X-Microsystems/xmicro-cf/README.md

# XMICRO-CF

[XMICRO](https://github.com/x-microsystems/xmicro-bus) card providing a CompactFlash card interface and real-time
clock.

Datasheet: [XMICRO-CF](Documentation/XMICRO-CF.pdf)

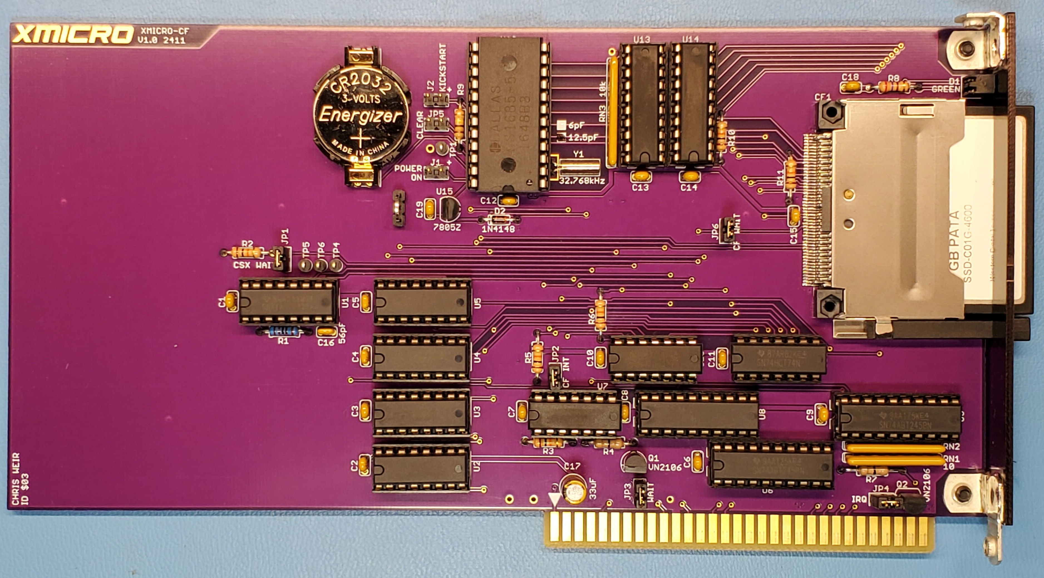
[picture p1: Images/XMICRO-CF 1.jpg]
XMICRO-CF
