X-Microsystems/xmicro-cf/Documentation/Schematics/Netlist.txt

Netlist

Exported from XMICRO-CF V1.0.sch at 2024-04-06 16:05:32

EAGLE Version 6.3.0 Copyright (c) 1988-2012 CadSoft

Net      Part     Pad      Pin        Sheet

!BCSX    P1       9        !CSX       1
         U8       2        A          1

!BIRQX   JP4      2        2          5
         P1       52       !IRQX      1

!BRD     P1       19       !RD        1
         U10      4        I0         1
         U8       3        A          1

!BRST    P1       10       !RST       1
         U7       5        I          1

!BWAIT   JP3      2        2          5
         P1       16       !WAIT      1

!BWR     P1       20       !WR        1
         U10      5        I1         1
         U8       4        A          1

!CF_CD   CF1      26       !CD1       2
         R10      2        2          2
         U14      4        A3         4

!CSX     TP4      1        1          5
         U1       9        A          5
         U2       4        G2A        4
         U3       4        G2A        4
         U4       4        G2A        4
         U8       18       B          1
         U9       19       !OE        1

!CS_CF0  CF1      7        !CS0       2
         U2       15       Y0         4

!CS_CF1  CF1      32       !CS1       2
         U2       14       Y1         4

!CS_ID   U13      19       !OE        4
         U4       7        Y7         4

!CS_IER  U11      11       CLK        5
         U3       15       Y0         4

!CS_RTC  U12      13       !CS        3
         U2       13       Y2         4
         U5       4        G2A        3

!CS_SR   U14      19       !OE        4
         U4       15       Y0         4

!INT_RTC R3       2        2          3
         U10      13       I1         5
         U12      19       !IRQ       3
         U7       3        I          5

!RD      CF1      34       !IORD      2
         U4       5        G2B        4
         U5       3        C          3
         U8       17       B          1
         U9       1        DIR        1

!RST     CF1      41       /RESET     2
         U1       11       CLR        5
         U11      10       PRE        5
         U7       8        O          1

!WAIT_CF CF1      42       IORDY      2
         JP6      1        1          5

!WAIT_CSX JP1      1        1          5
         TP5      1        1          5
         U1       12       !Q         5

!WR      CF1      35       !IOWR      2
         U3       5        G2B        4
         U5       2        B          3
         U8       16       B          1

+5V      C1       1        1          5
         C10      1        1          5
         C11      1        1          5
         C13      1        1          5
         C14      1        1          5
         C15      1        1          5
         C17      +        +          5
         C18      1        1          5
         C2       1        1          5
         C3       1        1          5
         C4       1        1          5
         C5       1        1          5
         C6       1        1          5
         C7       1        1          5
         C8       1        1          5
         C9       1        1          5
         CF1      13       +5V        * none *
         CF1      36       !WE        2
         CF1      38       +5V        * none *
         CF1      44       !DMACK     2
         P1       5        +5V        1
         P1       6        +5V        1
         R1       2        2          5
         R10      1        1          2
         R11      2        2          2
         R2       2        2          5
         R3       1        1          3
         R5       2        2          5
         R6       2        2          5
         R8       2        2          2
         RN3      1        1          1
         U1       1        A          5
         U1       16       +5V        * none *
         U1       2        B          5
         U1       3        CLR        5
         U10      14       +5V        * none *
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

N$47     R7       1        1          5
         U7       12       O          5

RWCYCLE  TP6      1        1          1
         U1       10       B          5
         U10      6        O          1

SR_RTC   U14      2        A1         4
         U7       4        O          5
