X-Microsystems/xmicro-cf/Documentation/XMICRO-CF.odt

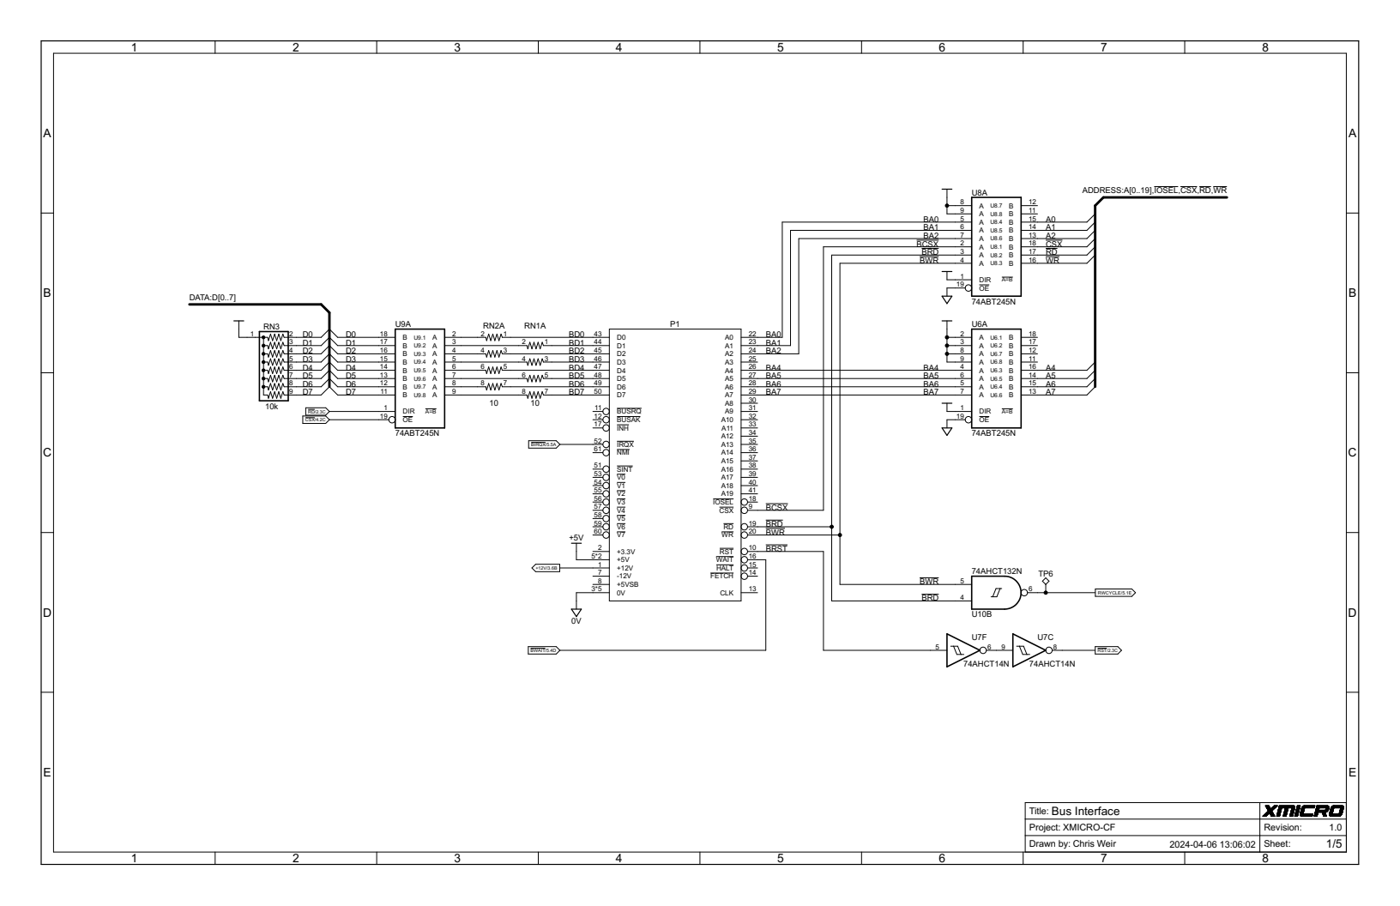
[picture p2: figure]
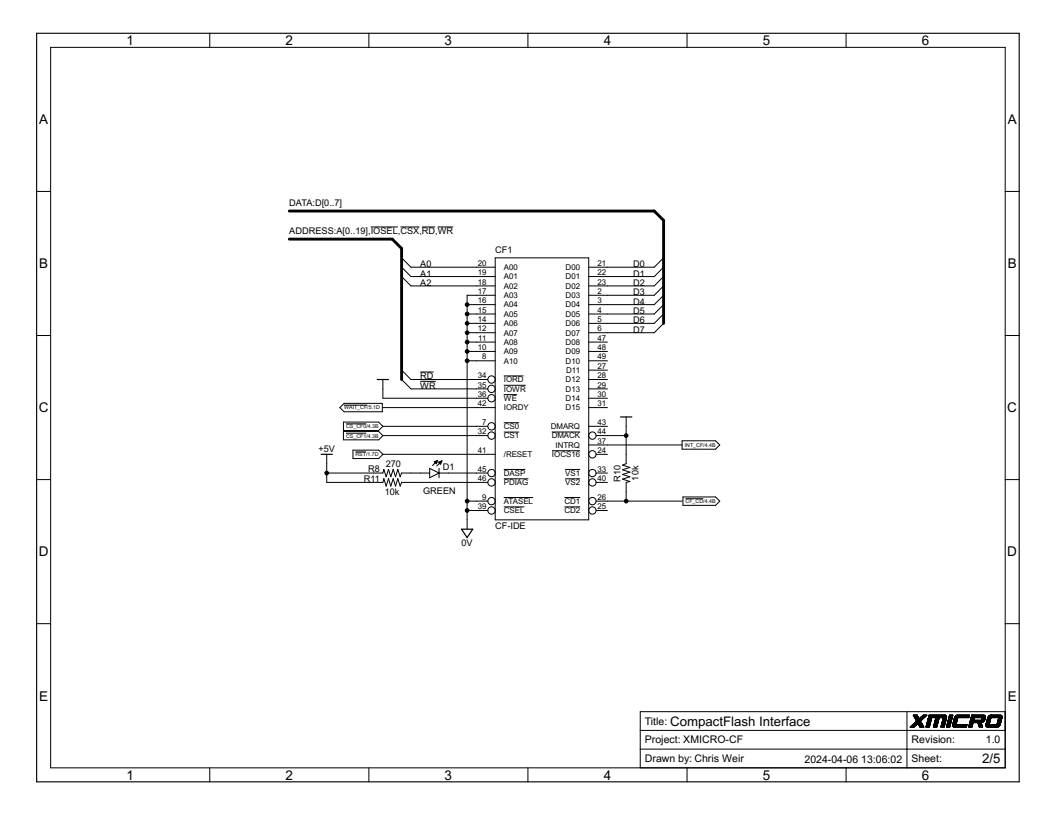
[picture p3: figure]
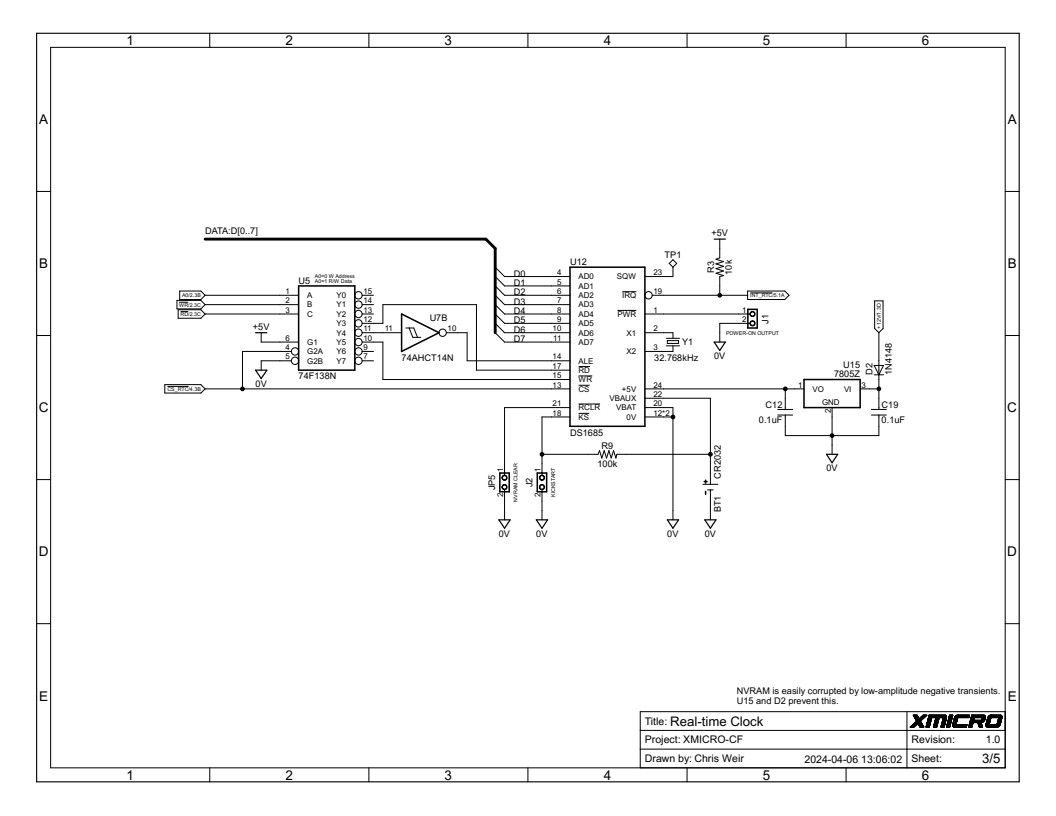
[picture p4: figure]
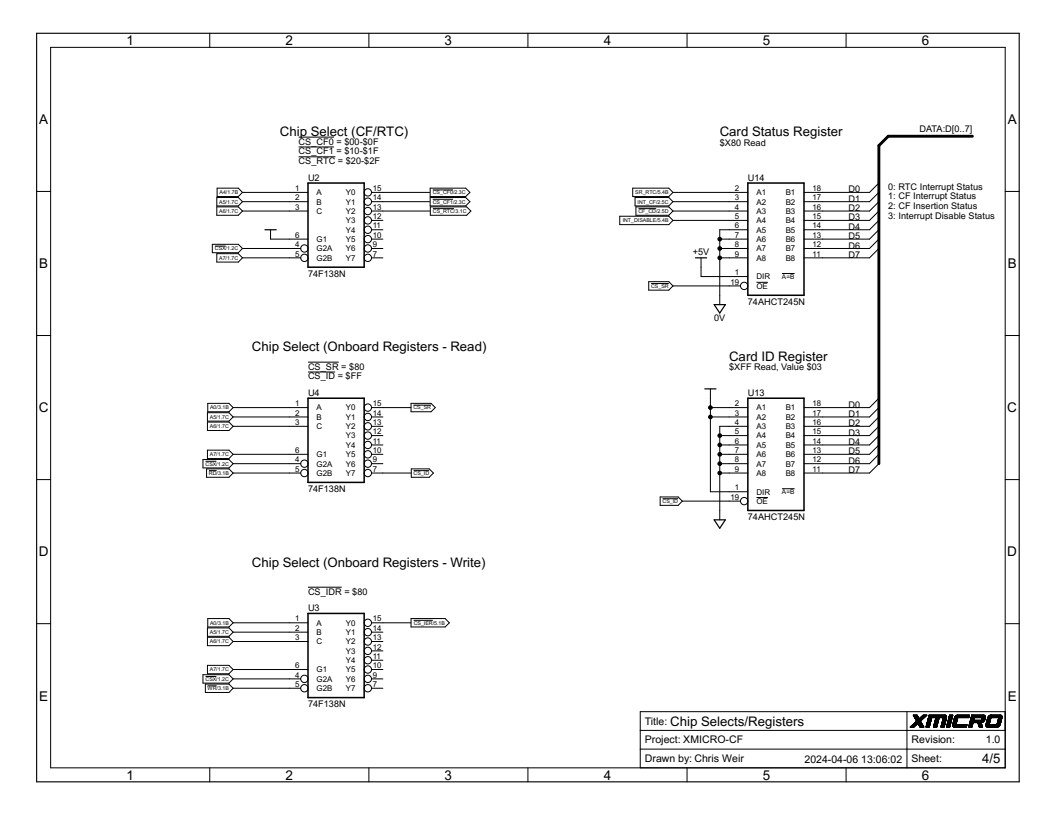
[picture p5: figure]
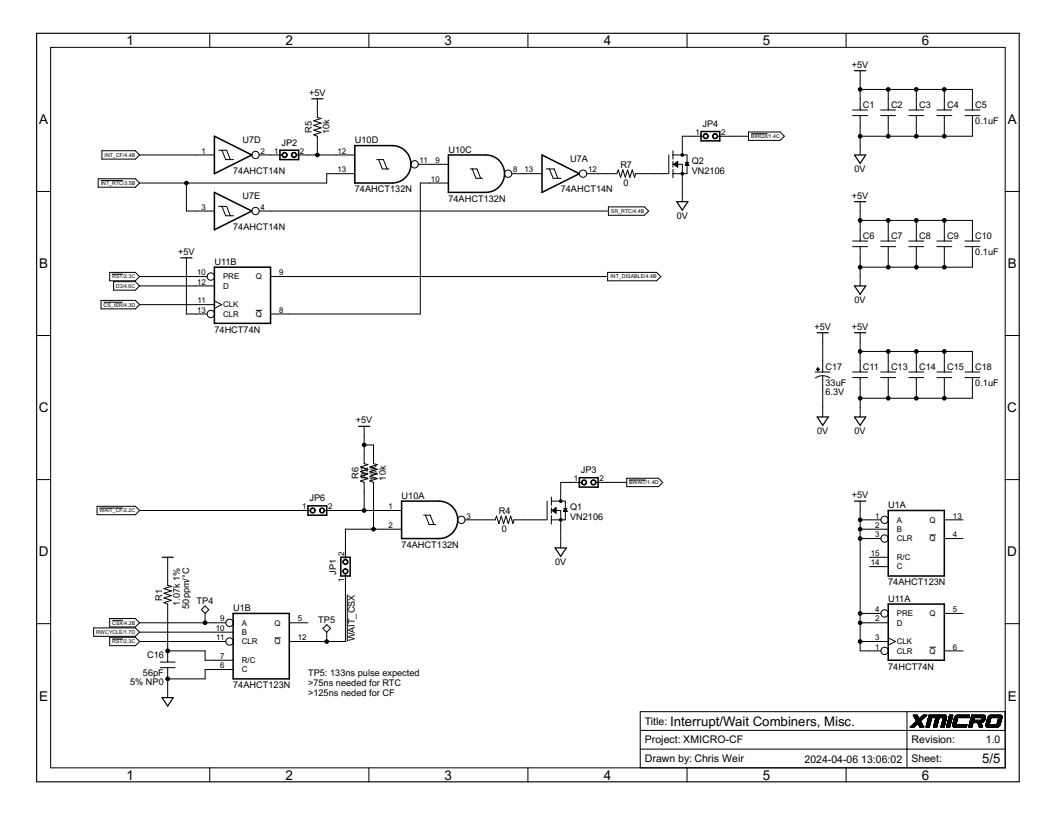
[picture p6: figure]

# General Description

The XMICRO-CF is an XMICRO slave card providing a CompactFlash card interface and real-time clock.

## Features

- IDE Mode CompactFlash interface
- Real-time clock with programmable interrupts
- 242 bytes of non-volatile memory
- Software-controllable system power-on function

## System Outline

Table 1: Card Memory Map Address Range Function $X00-$X1F CompactFlash Card $X20 RTC Address (W) $X21 RTC Data $X80 Card Status Register $XFF Card ID Register (R) | Table 2: Card Configuration Setting Function JP1 Enable wait states for all card accesses JP2 Enable CF interrupts JP3 Enable bus WAIT signal JP4 Enable bus IRQ signal JP5 Clear RTC NVRAM JP6 Enable CF-generated wait states

# CompactFlash Interface

The CompactFlash interface provides removable high-capacity storage to the system using widely available CompactFlash cards. This allows for data to be transferred between XMICRO systems, PCs, and other compatible devices. Refer to the CompactFlash specifications for more information on interacting with these cards.

The CompactFlash interface is implemented in 8-bit IDE mode. The CF card must be initialized in 8-bit mode to work properly. Native DMA is therefore not implemented, as it is a 16-bit function.

# Real-Time Clock

The DS1685 RTC can accept either 6pF or 12.5pF crystals. During assembly, the board should be marked to indicate which crystal value is installed. To maintain accurate timekeeping, it is important that the Crystal Select bit (bit 5) of Extended Control Register $4B is set to correctly reflect the installed crystal.

The RTC’s Kickstart function allows an optional soft power control of the system. To use this, a momentary power switch is connected to J2, and J1 is connected to the backplane’s Power-on switch header. The polarity of J1 may need to be reversed for correct operation if the system always remains on.

The DS1685 is highly sensitive to negative transients on the power input and is prone to corruption if they occur. To protect against this, the RTC is powered by an independent +5V regulator U15 through diode D2.

# Onboard Registers

Table 3: Card Registers

Address | D7 | D6 | D5 | D4 | D3 | D2 | D1 | D0
$X80 | 0 | 0 | 0 | 0 | Interrupt Disable (R/W) | CF Insertion Status (R) | CF Interrupt Status (R) | RTC Interrupt Status (R)
$XFF | Card ID $03 (R)

## Card Status Register ($X80)

The CSR is used to determine basic status of the card’s functions in a single read operation. CSR bits indicate the following:

CSR Bit 0:

0: RTC interrupt is not asserted

1: RTC interrupt is asserted

CSR Bit 1:

0: CompactFlash interrupt is not asserted

1: CompactFlash interrupt is asserted

CSR Bit 2:

0: CompactFlash card is present

1: CompactFlash card is not present

CSR Bit 3:

0: Onboard interrupts are allowed

1: All interrupts are disabled (Default at reset)

## Card ID Register ($XFF)

The Card ID Register contains the ID value $03 as assigned in XMICRO Bus specification Appendix A. This register is used by the system to determine card types and locations.
