X-Microsystems/xmicro-cf/Images/XMICRO-CF 2.jpg

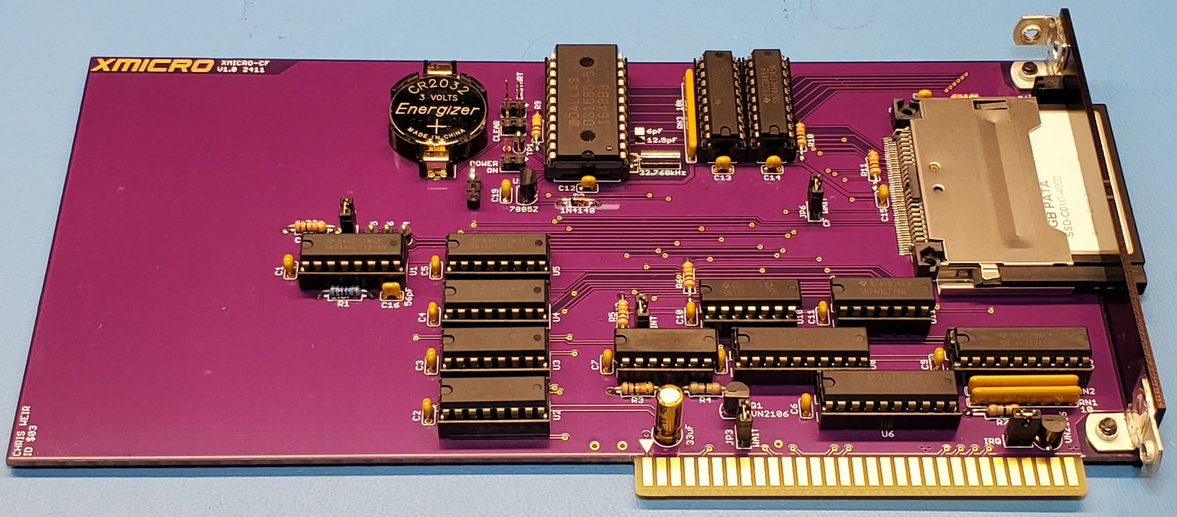
Images/XMICRO-CF 2.jpg
