X-Microsystems/xmicro-cf/Documentation/XMICRO-CF.pdf

# XMCIRO-CF

2024-09-29 | Hardware V1.0 2414

### 1. General Description

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

### 1.1 Features

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

### 1.2 System Outline

# Table 1: Card Memory Map

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

# Table 2: Card Configuration

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

### 2. CompactFlash Interface

The CompactFlash interface provides removable high-capacity storage to the system using widely available

CompactFlash cards. This allows for data to be transferred between XMICRO systems, PCs, and other

compatible devices. Refer to the CompactFlash specifications for more information on interacting with these

cards.

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

work properly. Native DMA is therefore not implemented, as it is a 16-bit function.

### 3. Real-Time Clock

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

bit (bit 5) of Extended Control Register $4B is set to correctly reflect the installed crystal.

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

J1 may need to be reversed for correct operation if the system always remains on.

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

1

### 4. Onboard Registers

# Table 3: Card Registers

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

### 4.1 Card Status Register ($X80)

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

the following:

CSR Bit 0:
0: RTC interrupt is not asserted 1: RTC interrupt is asserted

CSR Bit 1:
0: CompactFlash interrupt is not asserted 1: CompactFlash interrupt is asserted

CSR Bit 2:
0: CompactFlash card is present
1: CompactFlash card is not present

CSR Bit 3:
0: Onboard interrupts are allowed
1: All interrupts are disabled (Default at reset)

### 4.2 Card ID Register ($XFF)

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

register is used by the system to determine card types and locations.

2

A

A

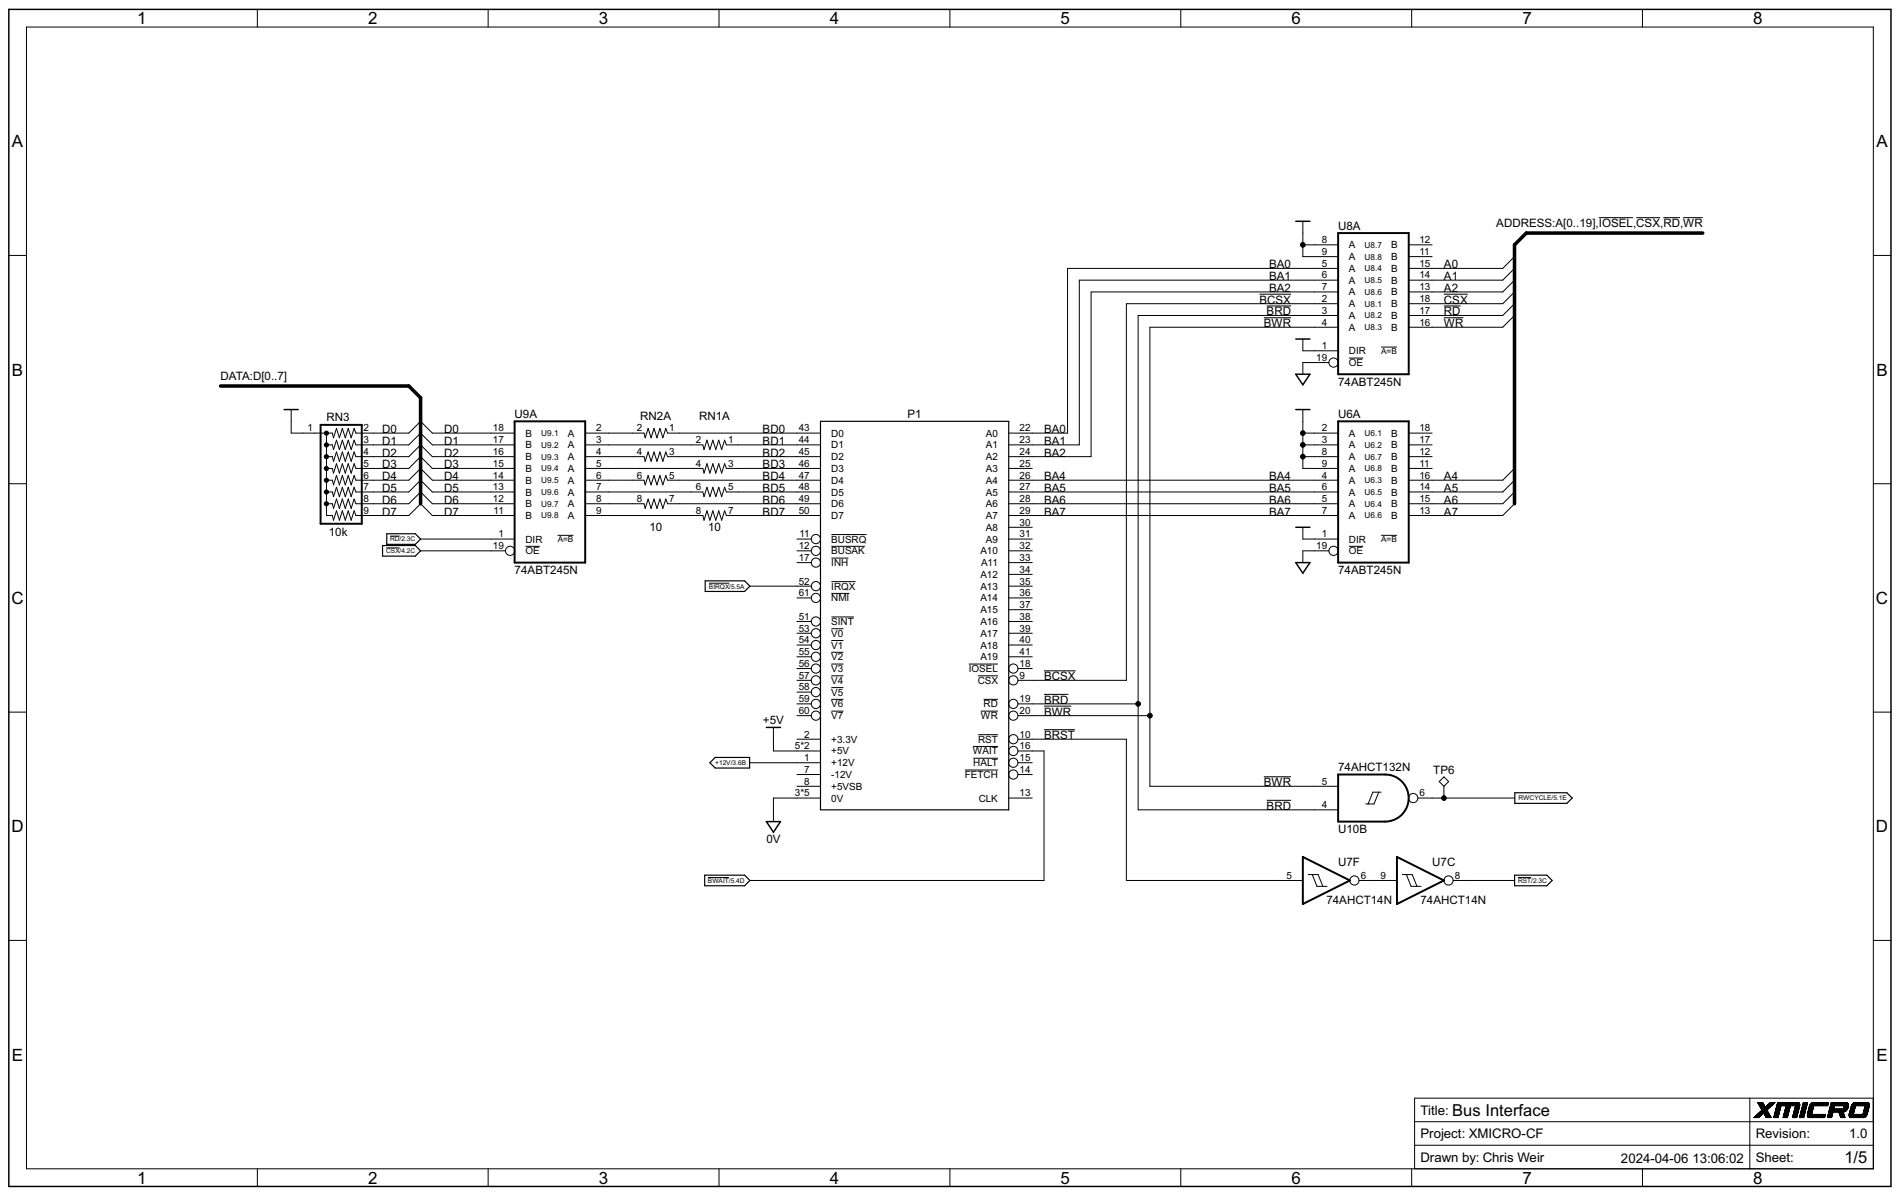
[picture p8: page 3]

ADDRESS:A[0..19],IOSEL,CSX,RD,WR

Title: Project: Drawn by: Bus Interface XMICRO-CF | Revision: Chris Weir Sheet: 1/5 1.0

A

A

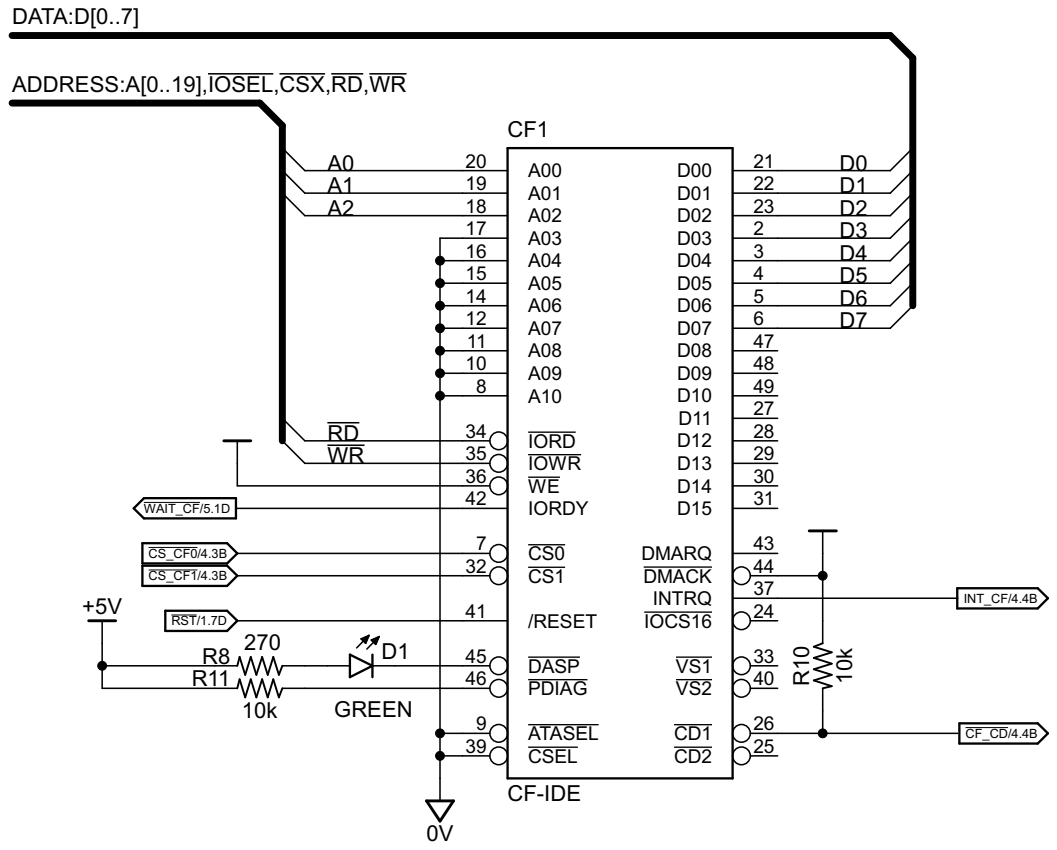
[picture p9: page 4]

ADDRESS:A[0..19],IOSEL,CSX,RD,WR

Drawn by: CompactFlash Interface

A

A

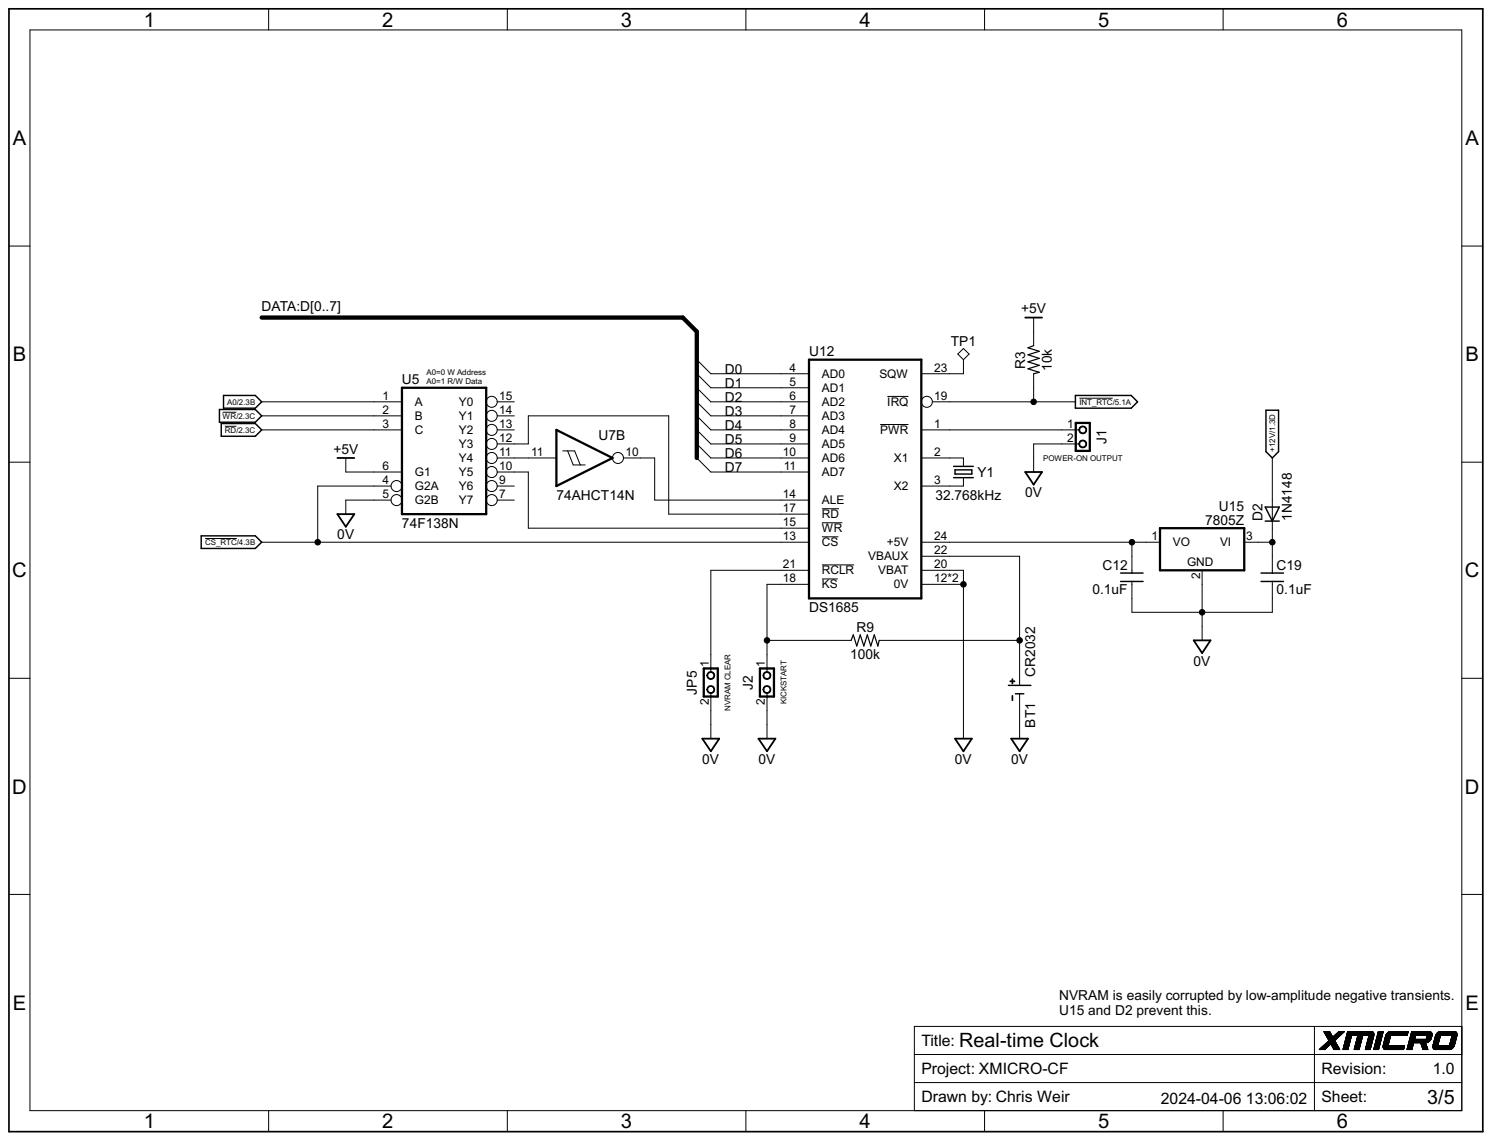
[picture p10: page 5]

NVRAM is easily corrupted by low-amplitude negative transients. U15 and D2 prevent this.

Drawn by: Real-time Clock

### Chip Select (CF/RTC)

### Card Status Register

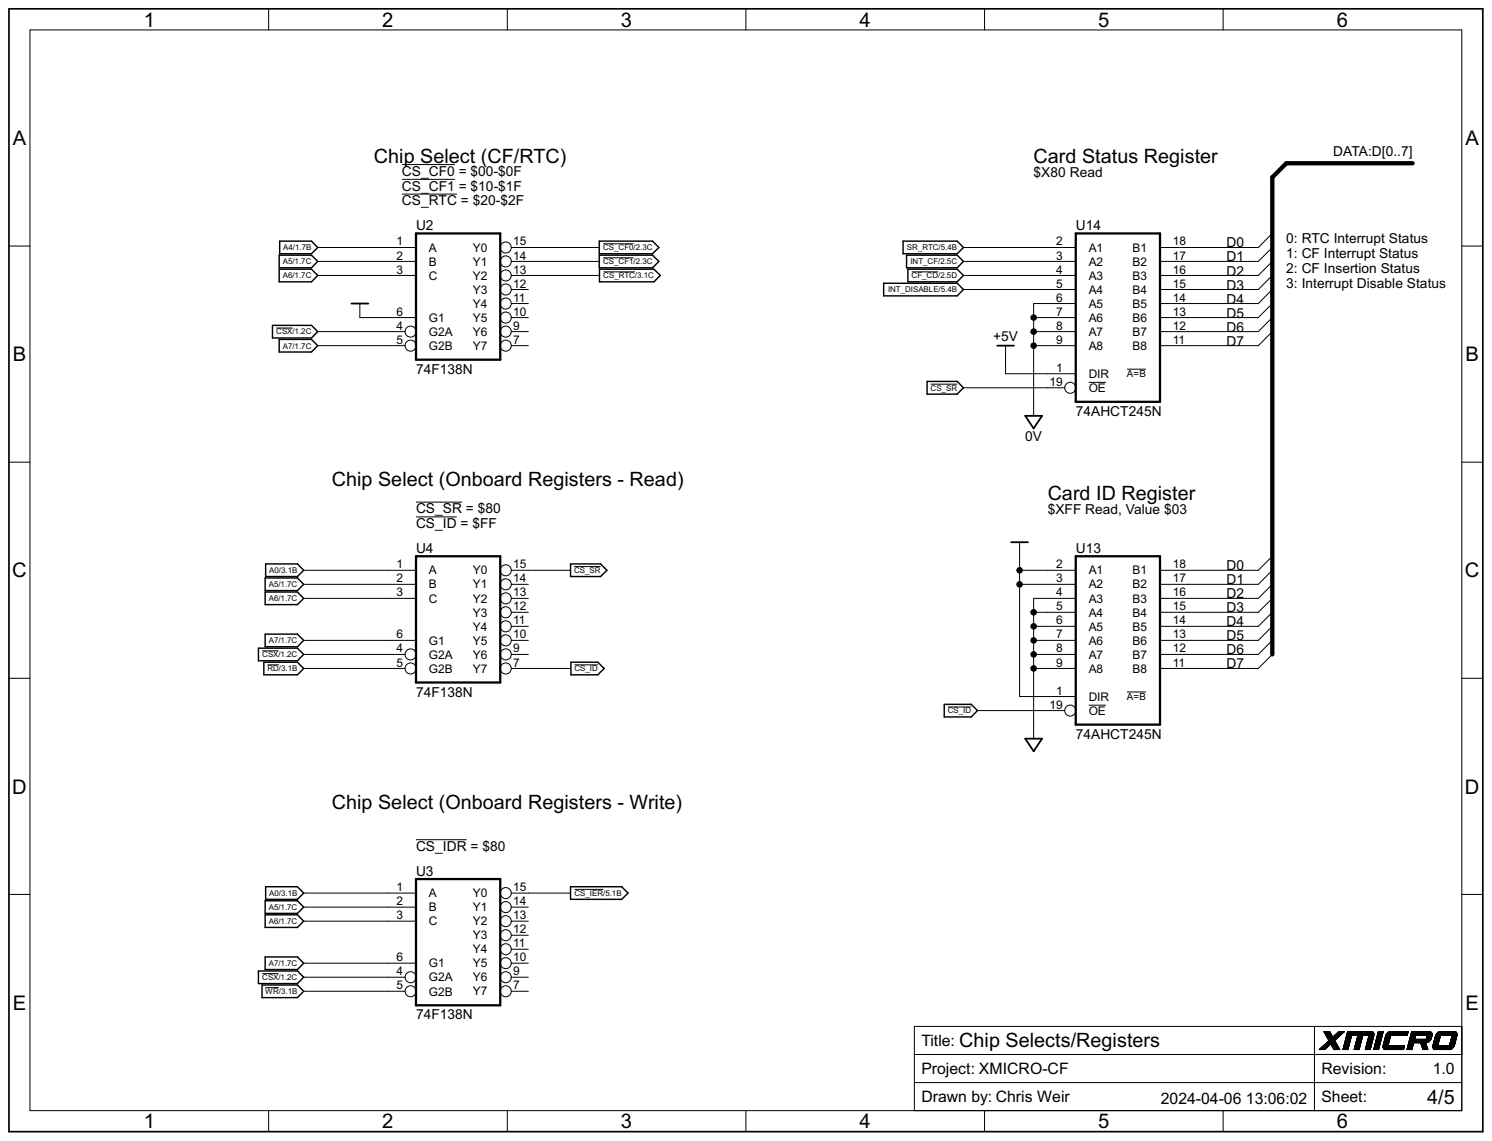
[picture p11: page 6]

0: RTC Interrupt Status 1: CF Interrupt Status 2: CF Insertion Status 3: Interrupt Disable Status

Chip Select (Onboard Registers - Read)

Chip Select (Onboard Registers - Write)

Drawn by: Chip Selects/Registers

A

A

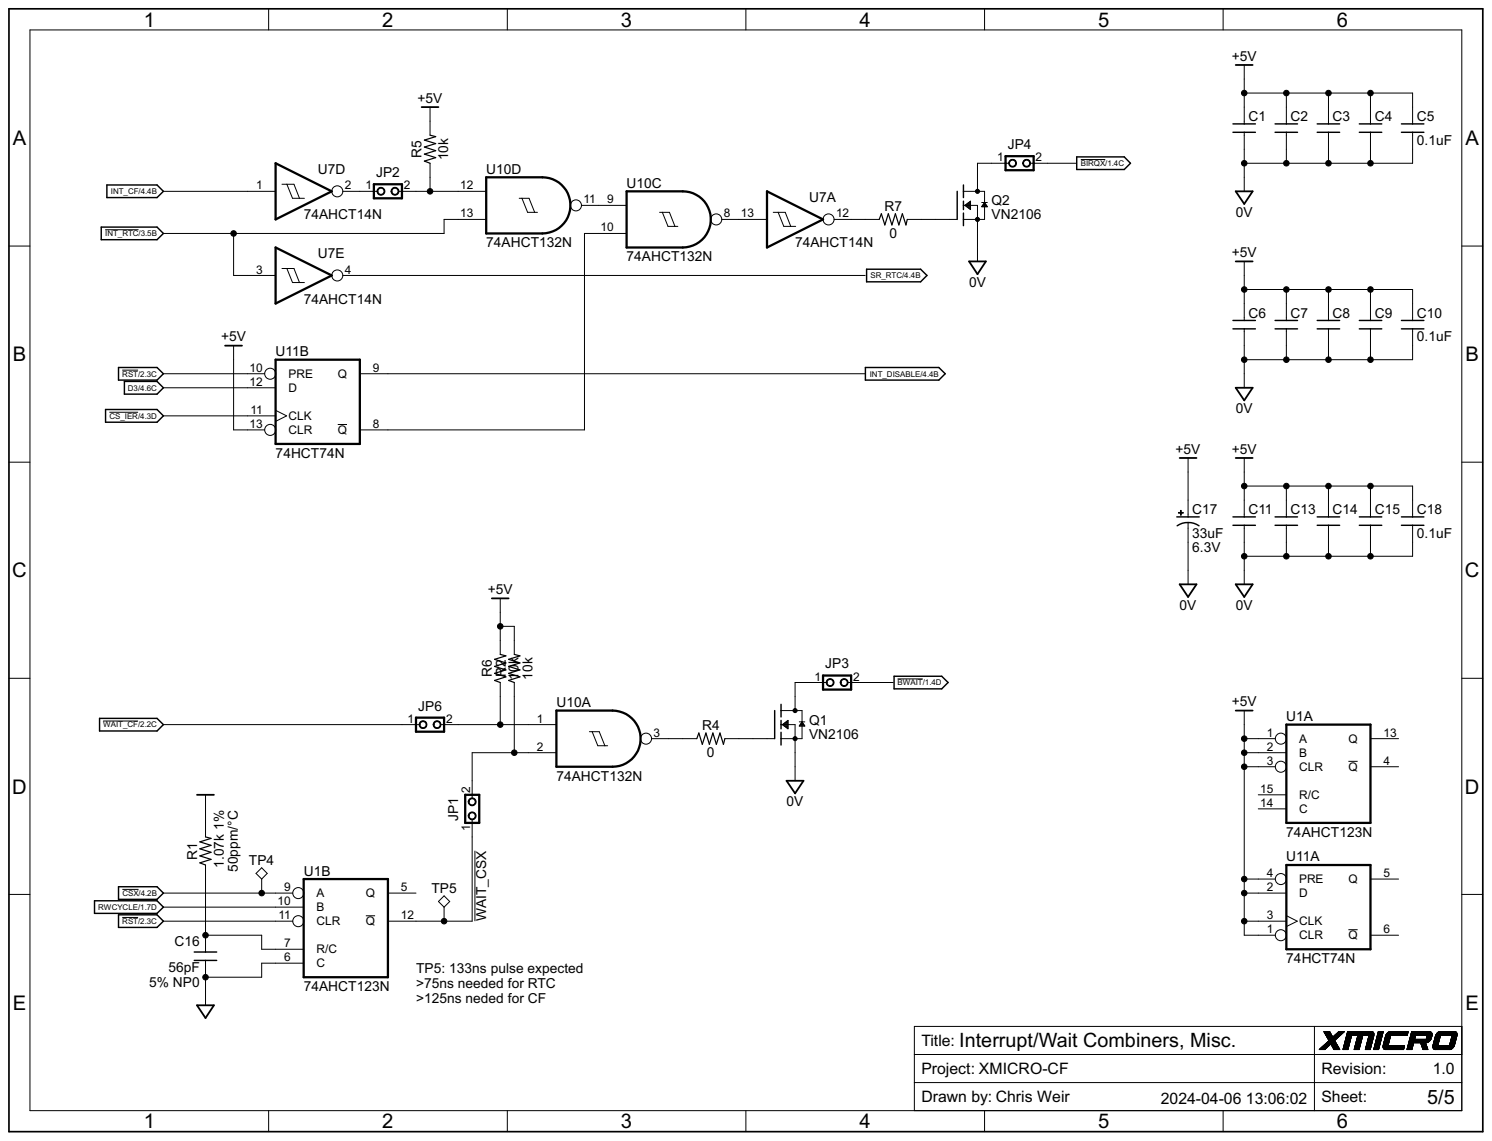
[picture p12: page 7]

TP5: 133ns pulse expected >75ns needed for RTC

Interrupt/Wait Combiners, Misc.
Title: Project: XMICRO-CF | Revision: Chris Weir Sheet: 5/5 1.0

Drawn by:
