X-Microsystems/xmicro-cf/Documentation/Schematics/XMICRO-CF V1.0 Black Large.pdf

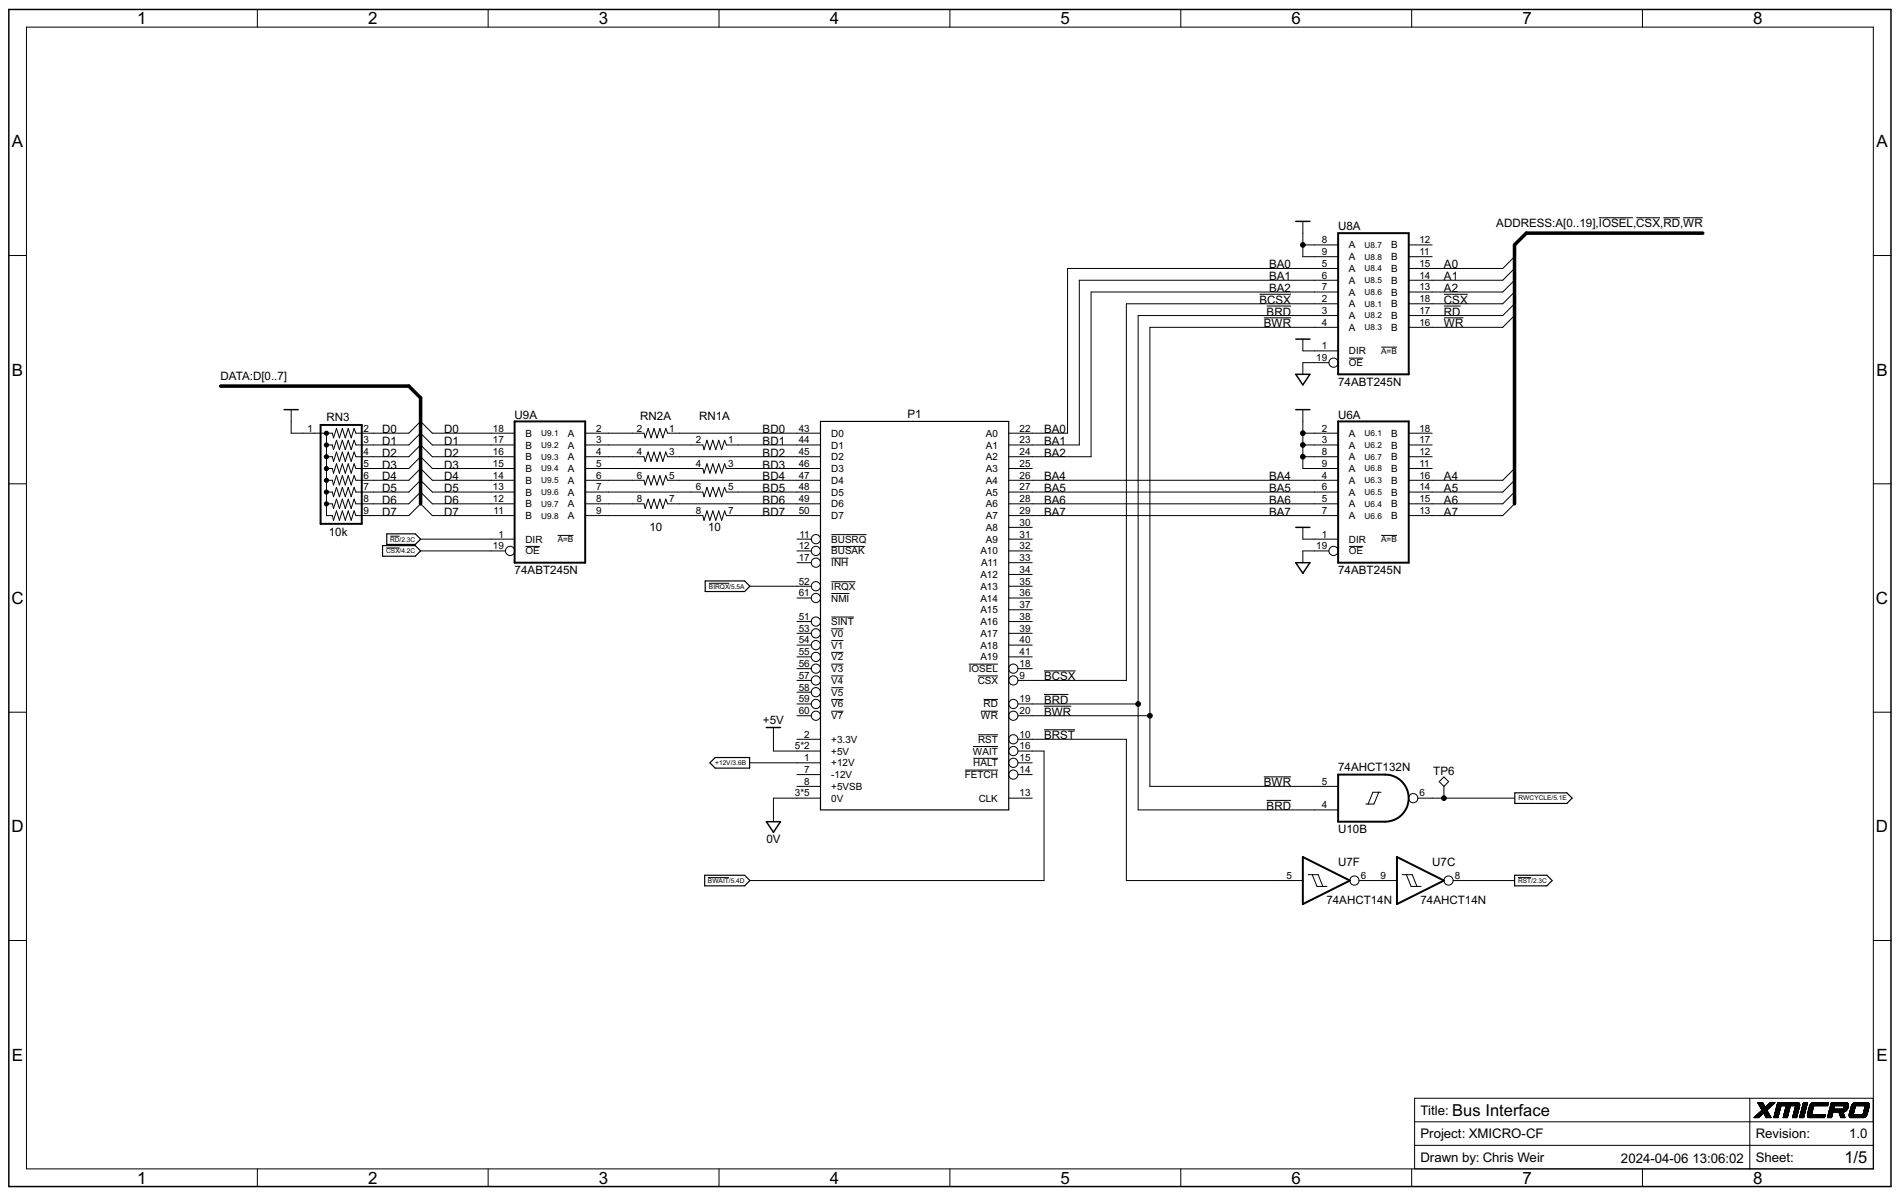
[picture p13: page 1]
