X-Microsystems/xmicro-cf/Documentation/Schematics/XMICRO-CF V1.0 Black.pdf

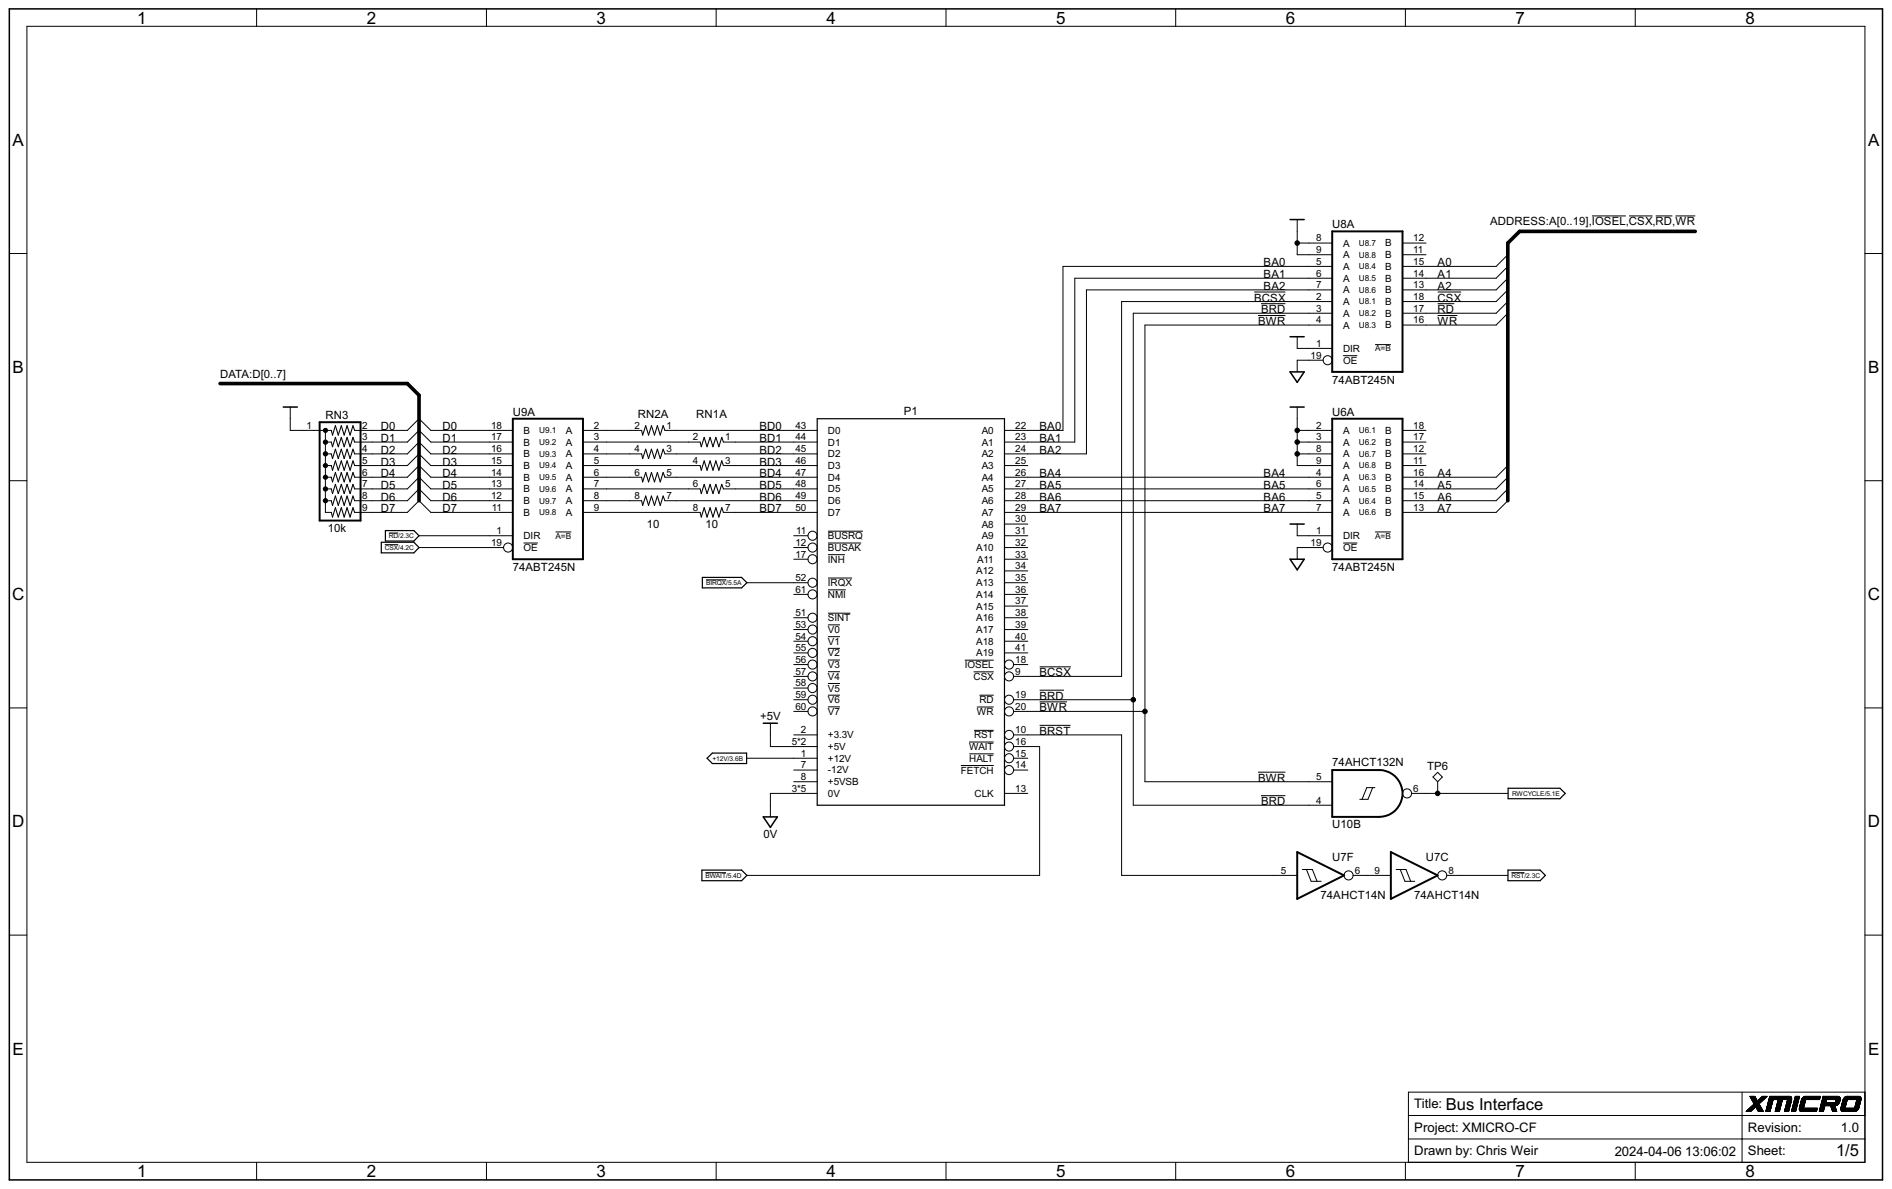
[picture p14: page 1]

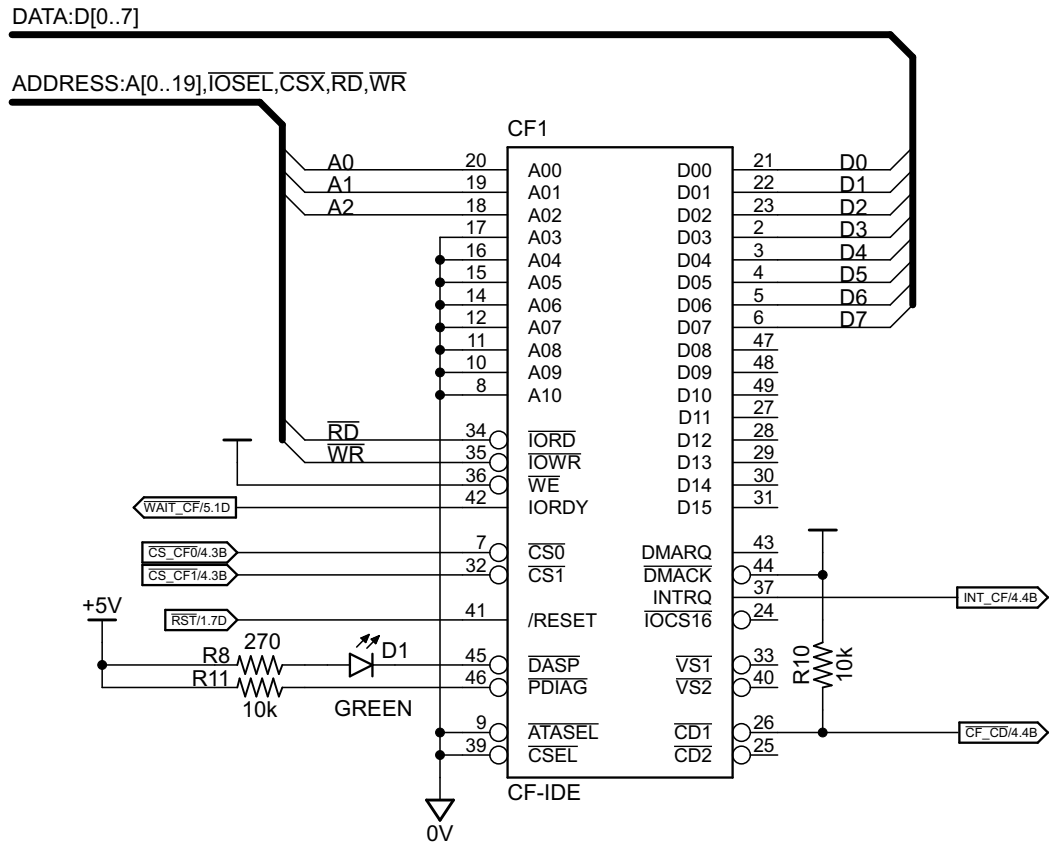
[picture p15: page 2]

ADDRESS:A[0..19],IOSEL,CSX,RD,WR

Title: Project: Drawn by: CompactFlash Interface XMICRO-CF | Revision: Chris Weir Sheet: 2/5 1.0

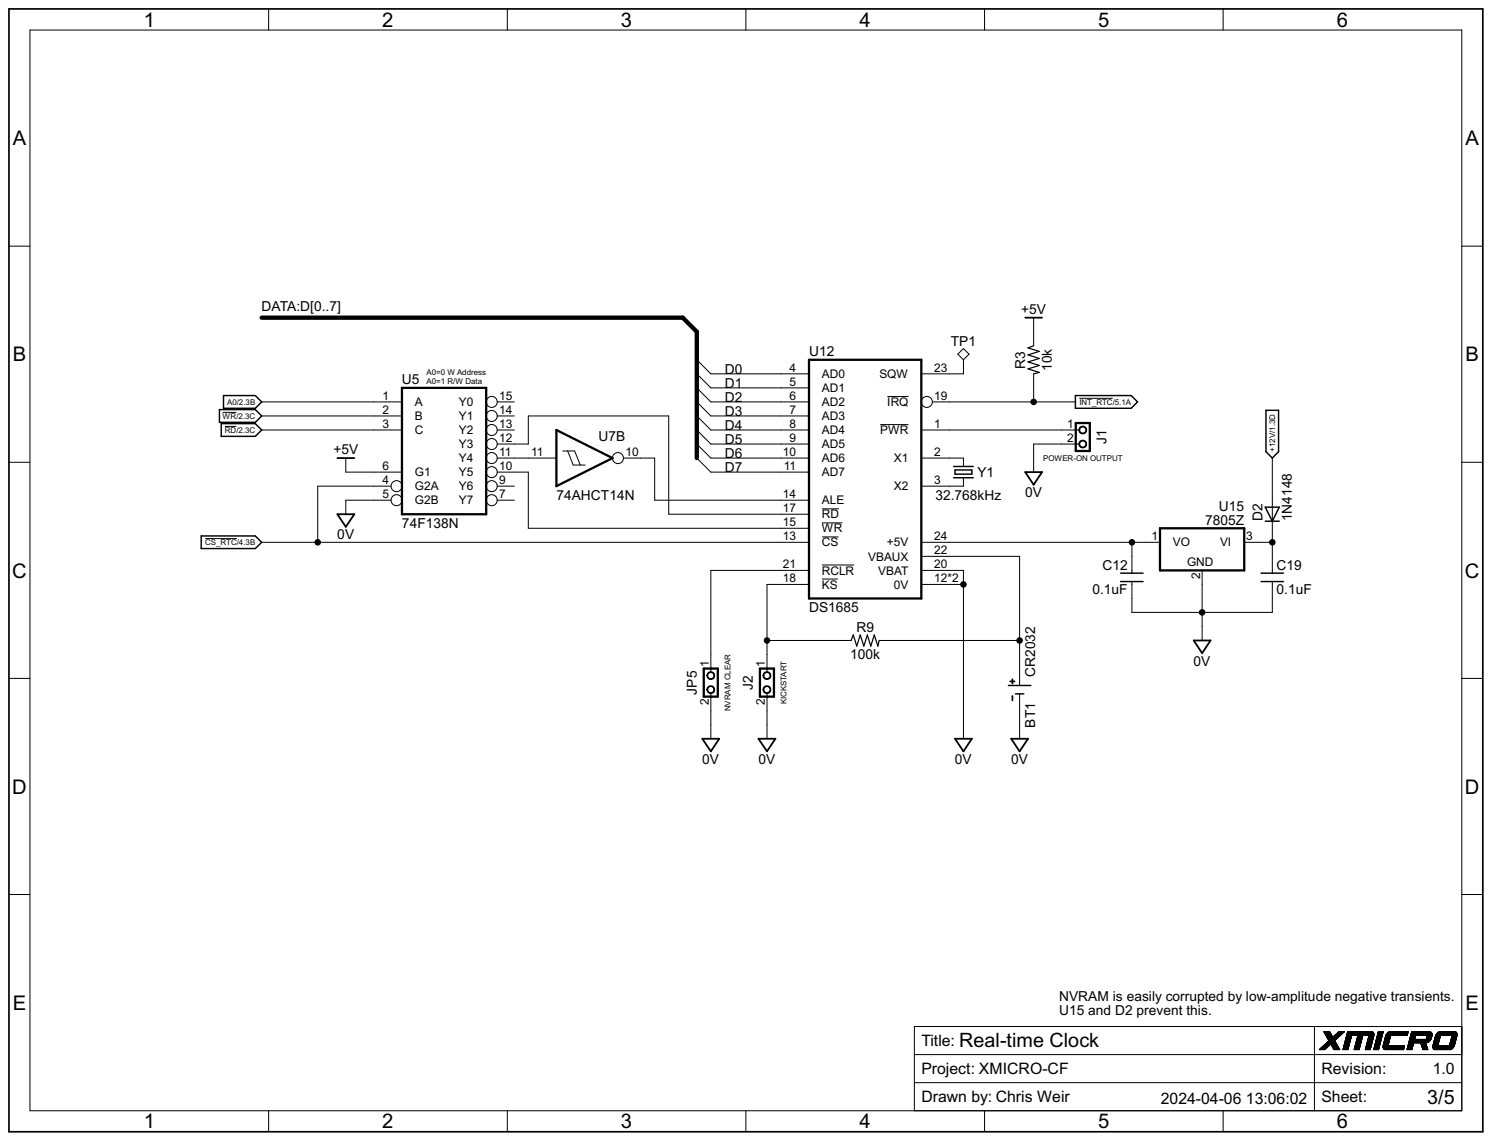
[picture p16: page 3]

NVRAM is easily corrupted by low-amplitude negative transients. U15 and D2 prevent this.

Drawn by: Real-time Clock

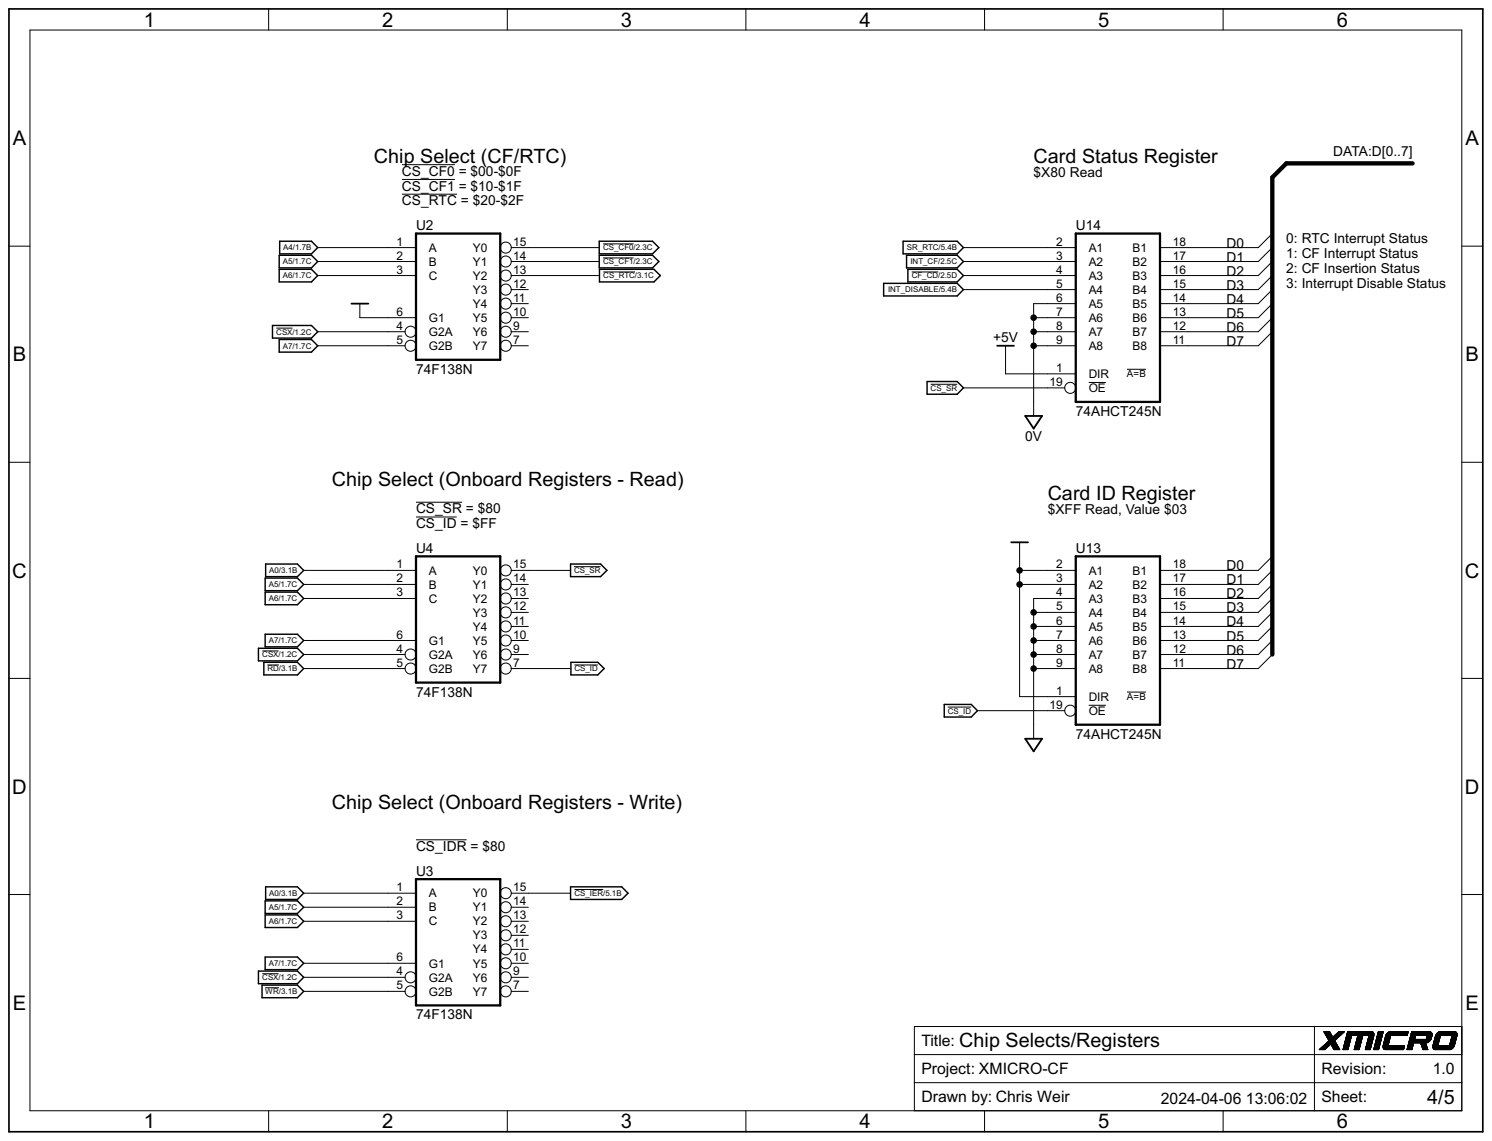
[picture p17: page 4]

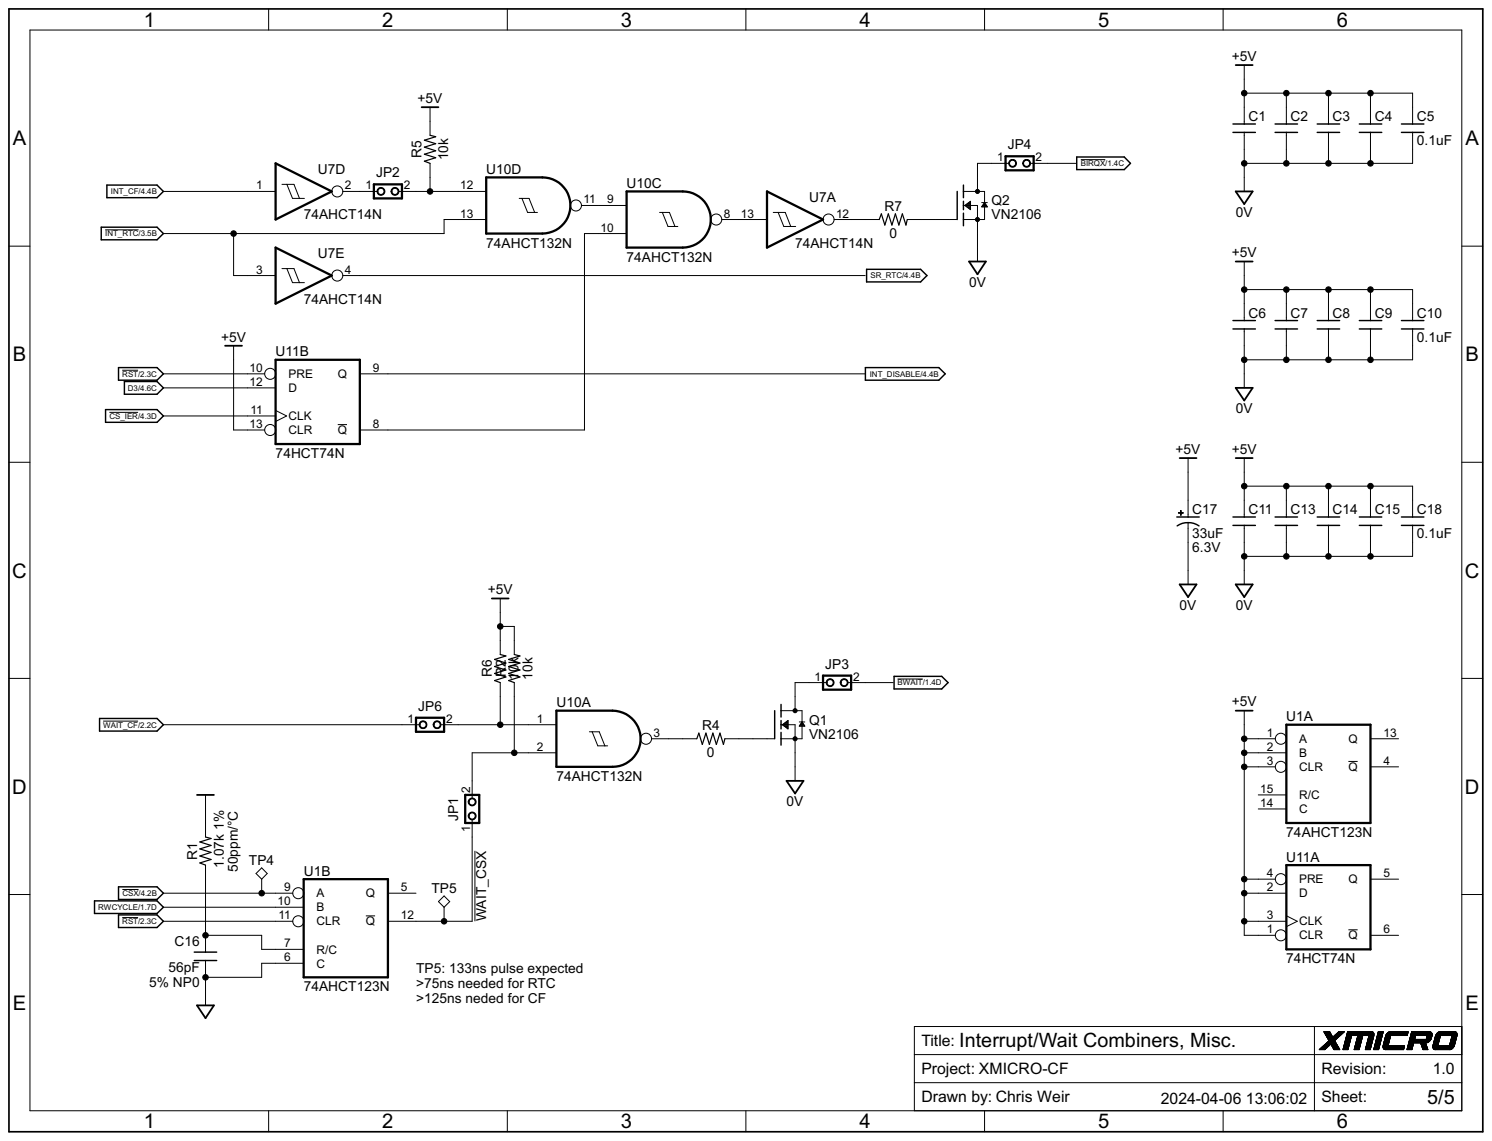
[picture p18: page 5]

TP5: 133ns pulse expected >75ns needed for RTC

Interrupt/Wait Combiners, Misc.
Title: Project: XMICRO-CF | Revision: Chris Weir Sheet: 5/5 1.0

Drawn by:
