X-Microsystems/xmicro-cf/Documentation/Schematics/XMICRO-CF V1.0 Color Large.pdf

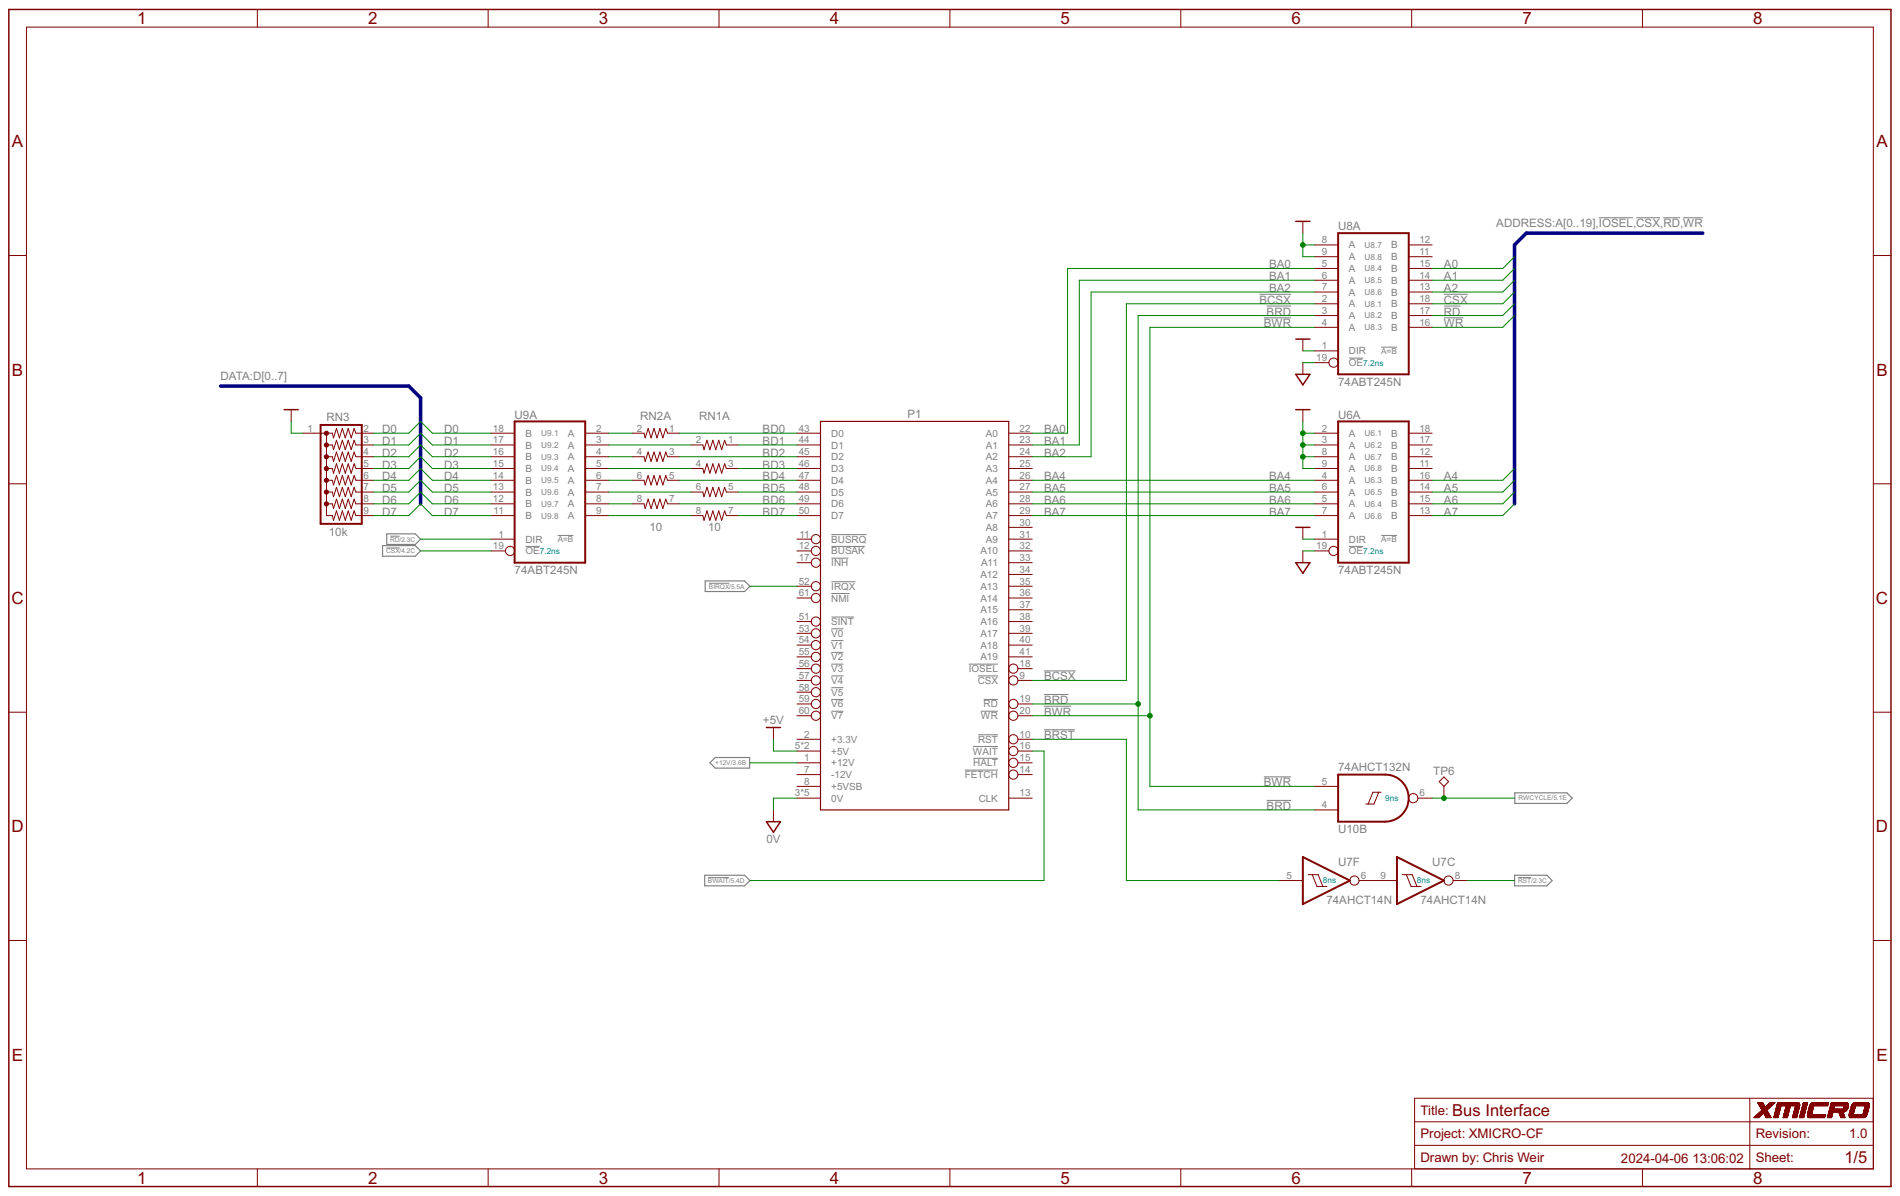
[picture p19: page 1]
