X-Microsystems/xmicro-cf/Documentation/Document Resources/3.pdf

NVRAM is easily corrupted by low-amplitude negative transients. U15 and D2 prevent this.

Title: Project: Drawn by: Real-time Clock XMICRO-CF | Revision: Chris Weir Sheet: 3/5 1.0
