X-Microsystems/xmicro-cf/Hardware/CAD/XMICRO-CF V1.0.brd

## EAGLE design Hardware/CAD/XMICRO-CF V1.0.brd (2024-09-08)

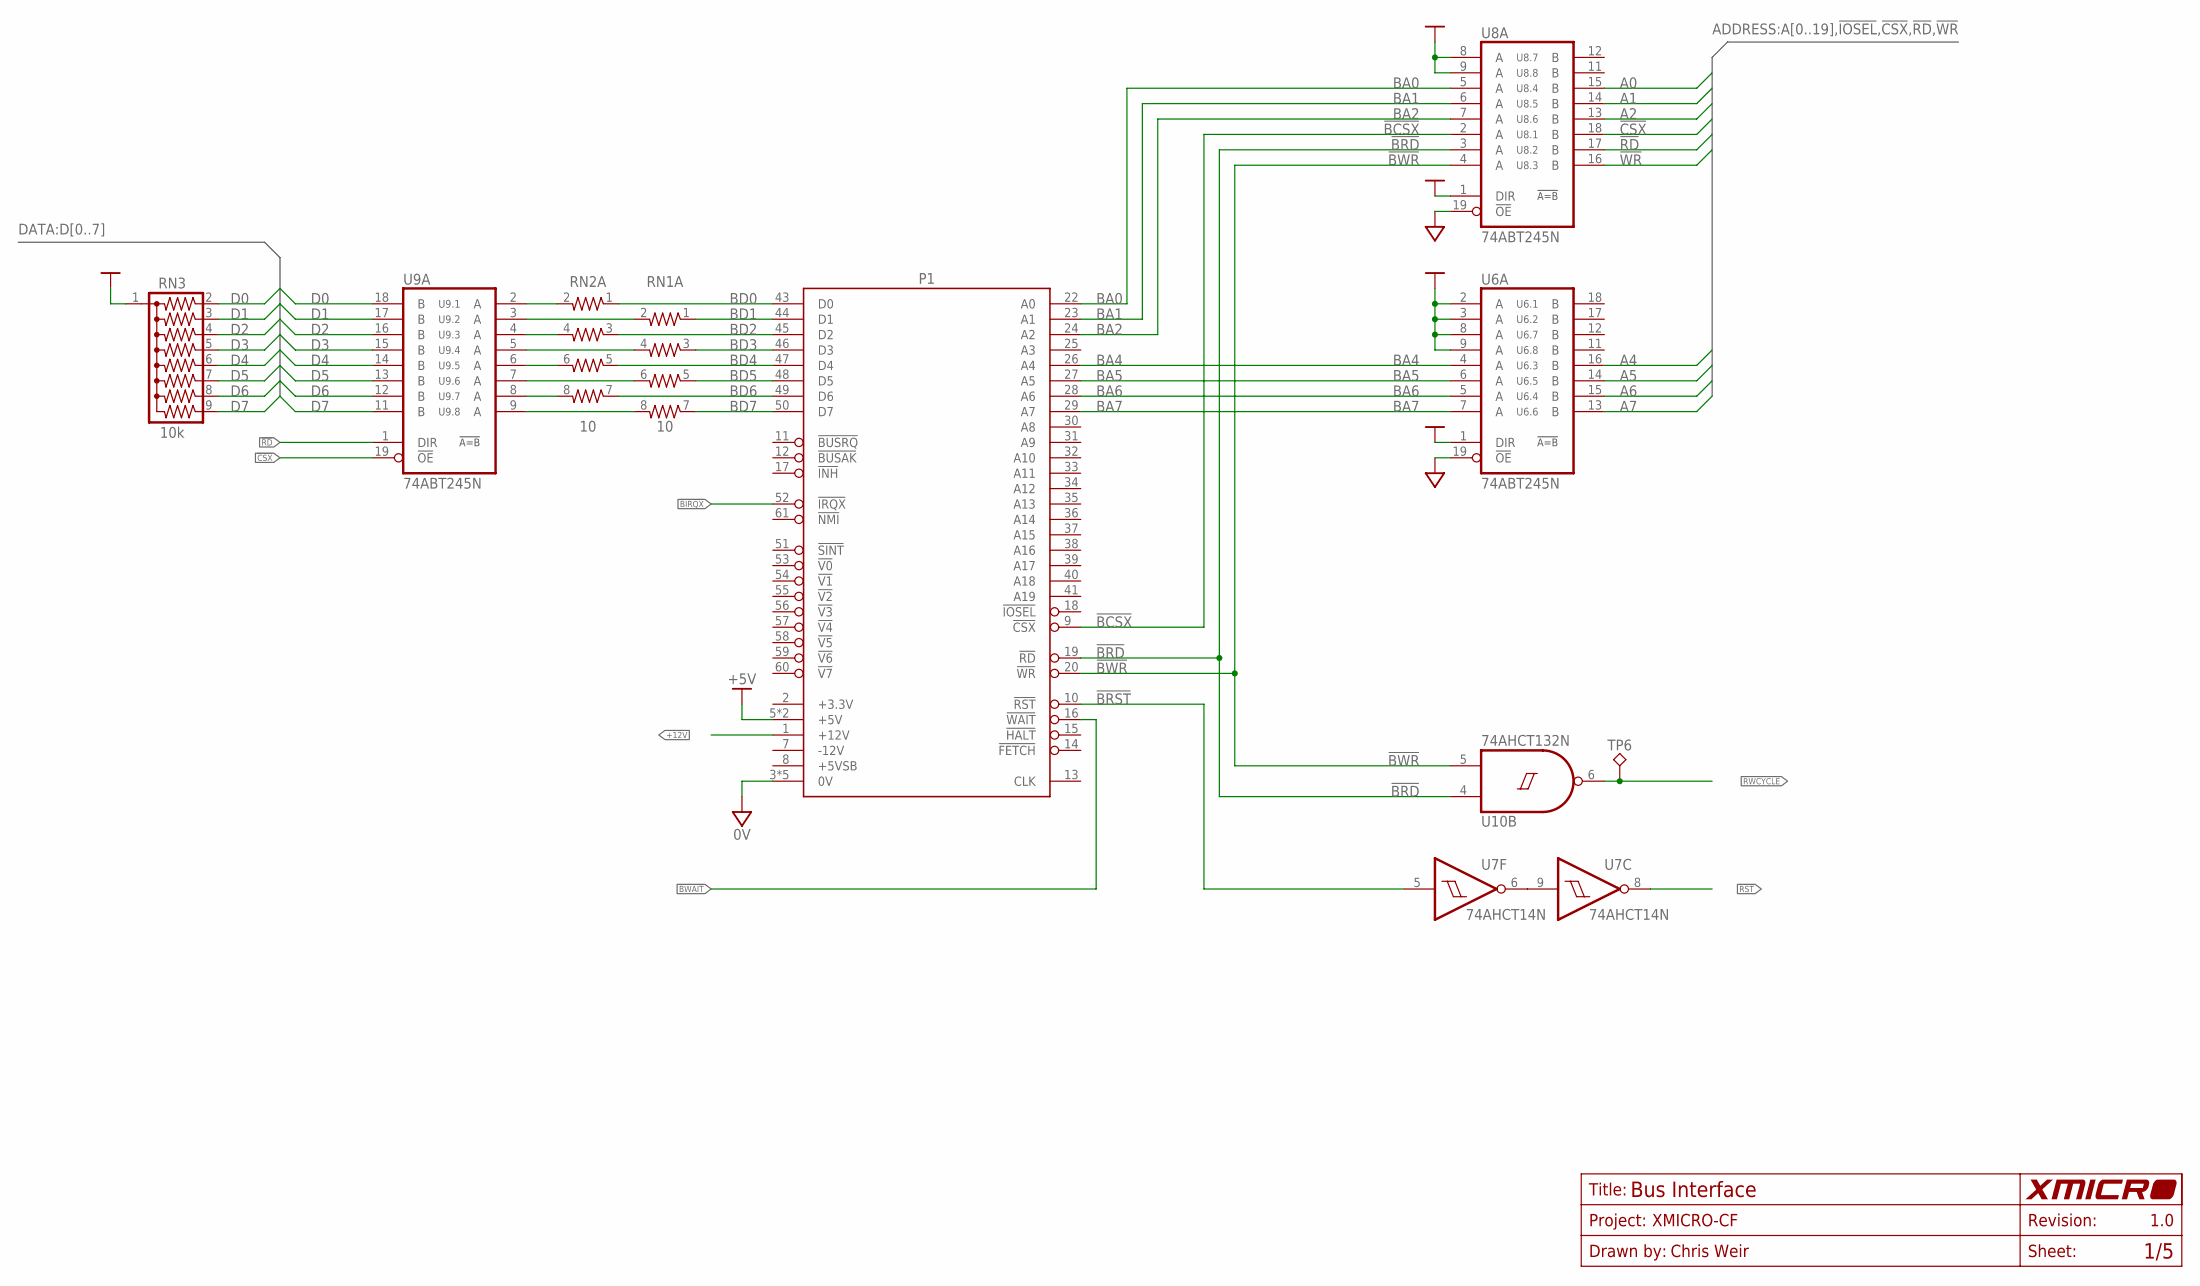
[picture p25: schematic XMICRO-CF V1.0.sch, sheet 1, Bus Interface]

Parts:
P1: XMICRO-BUS-EDGE; EDGE62M
RN1, RN2: 10; SIL8
RN3: 10k; SIL9
TP6: TP-040
U6, U8, U9: 74ABT245N; DIL20
U7: 74AHCT14N; DIL14
U10: 74AHCT132N; DIL14

Connections:
0V: P1.3 (0V), P1.4 (0V), P1.21 (0V), P1.42 (0V), P1.62 (0V), U6.10 (0V), U6.19 (!OE), U7.7 (0V), U8.10 (0V), U8.19 (!OE), U9.10 (0V), U10.7 (0V); also elsewhere on the board
!BCSX: P1.9 (!CSX), U8.2 (A)
!BIRQX: P1.52 (!IRQX); also elsewhere on the board
!BRD: P1.19 (!RD), U8.3 (A), U10.4 (I0)
!BRST: P1.10 (!RST), U7.5 (I)
!BWAIT: P1.16 (!WAIT); also elsewhere on the board
!BWR: P1.20 (!WR), U8.4 (A), U10.5 (I1)
!CSX: U8.18 (B), U9.19 (!OE); also elsewhere on the board
!RD: U8.17 (B), U9.1 (DIR); also elsewhere on the board
!RST: U7.8 (O); also elsewhere on the board
!WR: U8.16 (B); also elsewhere on the board
+5V: P1.5 (+5V), P1.6 (+5V), RN3.1, U6.1 (DIR), U6.2 (A), U6.3 (A), U6.8 (A), U6.9 (A), U6.20 (+5V), U7.14 (+5V), U8.1 (DIR), U8.8 (A), U8.9 (A), U8.20 (+5V), U9.20 (+5V), U10.14 (+5V); also elsewhere on the board
+12V: P1.1 (+12V); also elsewhere on the board
A0: U8.15 (B); also elsewhere on the board
A1: U8.14 (B); also elsewhere on the board
A2: U8.13 (B); also elsewhere on the board
A4: U6.16 (B); also elsewhere on the board
A5: U6.14 (B); also elsewhere on the board
A6: U6.15 (B); also elsewhere on the board
A7: U6.13 (B); also elsewhere on the board
BA0: P1.22 (A0), U8.5 (A)
BA1: P1.23 (A1), U8.6 (A)
BA2: P1.24 (A2), U8.7 (A)
BA4: P1.26 (A4), U6.4 (A)
BA5: P1.27 (A5), U6.6 (A)
BA6: P1.28 (A6), U6.5 (A)
BA7: P1.29 (A7), U6.7 (A)
BD0: P1.43 (D0), RN2.1
BD1: P1.44 (D1), RN1.1
BD2: P1.45 (D2), RN2.3 (1)
BD3: P1.46 (D3), RN1.3 (1)
BD4: P1.47 (D4), RN2.5 (1)
BD5: P1.48 (D5), RN1.5 (1)
BD6: P1.49 (D6), RN2.7 (1)
BD7: P1.50 (D7), RN1.7 (1)
D0: RN3.2, U9.18 (B); also elsewhere on the board
D1: RN3.3, U9.17 (B); also elsewhere on the board
D2: RN3.4, U9.16 (B); also elsewhere on the board
D3: RN3.5, U9.15 (B); also elsewhere on the board
D4: RN3.6, U9.14 (B); also elsewhere on the board
D5: RN3.7, U9.13 (B); also elsewhere on the board
D6: RN3.8, U9.12 (B); also elsewhere on the board
D7: RN3.9, U9.11 (B); also elsewhere on the board
unnamed: U7.6 (O), U7.9 (I)
unnamed: RN2.2, U9.2 (A)
unnamed: RN1.2, U9.3 (A)
unnamed: RN2.4 (2), U9.4 (A)
unnamed: RN1.4 (2), U9.5 (A)
unnamed: RN2.6 (2), U9.6 (A)
unnamed: RN1.6 (2), U9.7 (A)
unnamed: RN2.8 (2), U9.8 (A)
unnamed: RN1.8 (2), U9.9 (A)
RWCYCLE: TP6.1, U10.6 (O); also elsewhere on the board

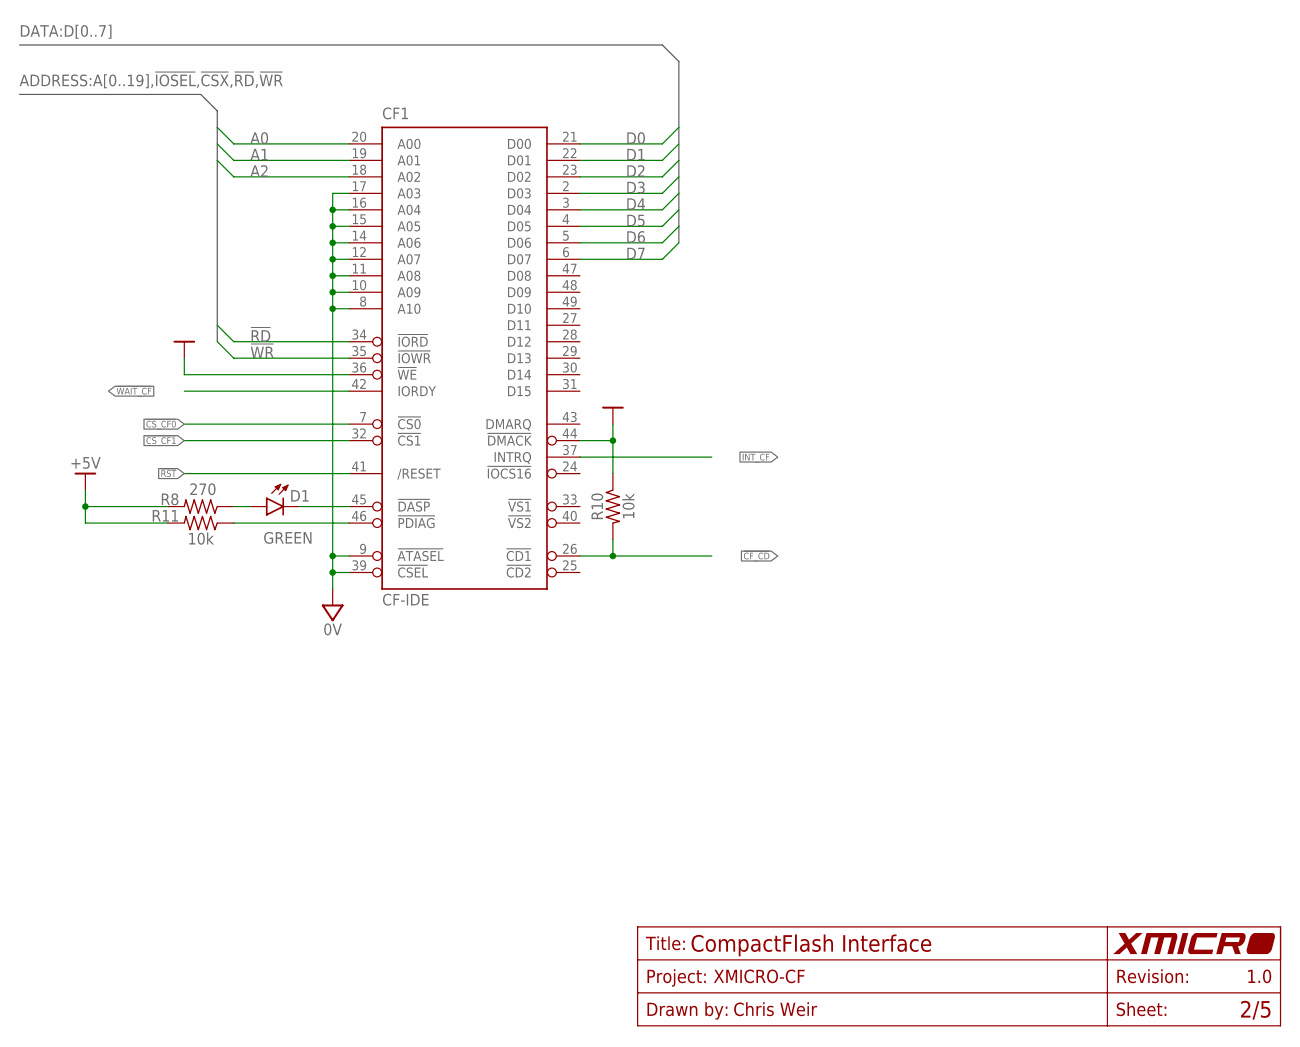
[picture p26: schematic XMICRO-CF V1.0.sch, sheet 2, CompactFlash Interface]

Parts:
CF1: CF-IDE; CF-KYOCERA
D1: GREEN; LED-3R
R8: 270; 0207/10
R10, R11: 10k; 0207/10

Connections:
0V: CF1.1 (0V), CF1.8 (A10), CF1.9 (!ATASEL), CF1.10 (A09), CF1.11 (A08), CF1.12 (A07), CF1.14 (A06), CF1.15 (A05), CF1.16 (A04), CF1.17 (A03), CF1.39 (!CSEL), CF1.50 (0V), CF1.M1 (0V), CF1.M2 (0V); also elsewhere on the board
!CF_CD: CF1.26 (!CD1), R10.2; also elsewhere on the board
!CS_CF0: CF1.7 (!CS0); also elsewhere on the board
!CS_CF1: CF1.32 (!CS1); also elsewhere on the board
!RD: CF1.34 (!IORD); also elsewhere on the board
!RST: CF1.41 (/RESET); also elsewhere on the board
!WAIT_CF: CF1.42 (IORDY); also elsewhere on the board
!WR: CF1.35 (!IOWR); also elsewhere on the board
+5V: CF1.13 (+5V), CF1.36 (!WE), CF1.38 (+5V), CF1.44 (!DMACK), R8.2, R10.1, R11.2; also elsewhere on the board
A0: CF1.20 (A00); also elsewhere on the board
A1: CF1.19 (A01); also elsewhere on the board
A2: CF1.18 (A02); also elsewhere on the board
D0: CF1.21 (D00); also elsewhere on the board
D1: CF1.22 (D01); also elsewhere on the board
D2: CF1.23 (D02); also elsewhere on the board
D3: CF1.2 (D03); also elsewhere on the board
D4: CF1.3 (D04); also elsewhere on the board
D5: CF1.4 (D05); also elsewhere on the board
D6: CF1.5 (D06); also elsewhere on the board
D7: CF1.6 (D07); also elsewhere on the board
INT_CF: CF1.37 (INTRQ); also elsewhere on the board
unnamed: CF1.45 (!DASP), D1.C
unnamed: D1.A, R8.1
unnamed: CF1.46 (!PDIAG), R11.1

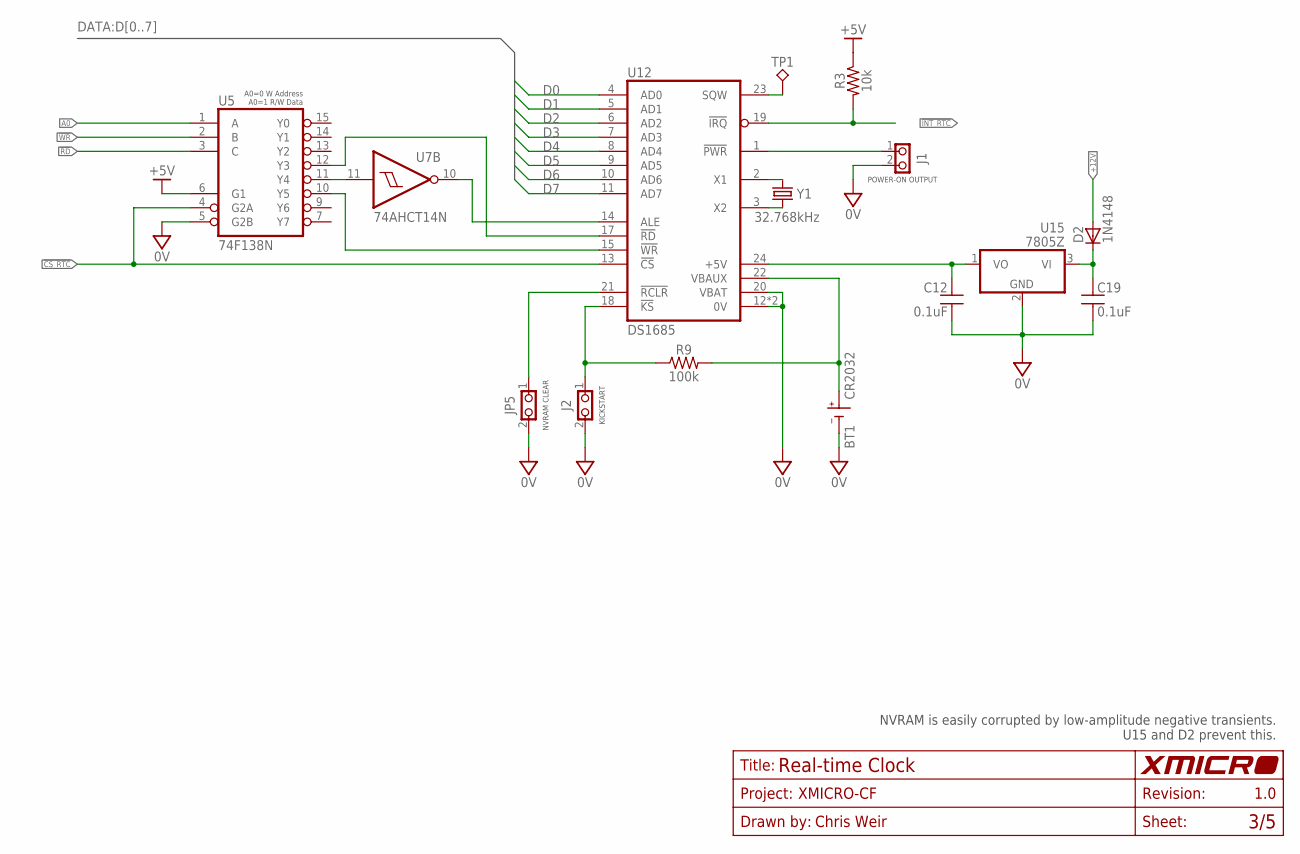
[picture p27: schematic XMICRO-CF V1.0.sch, sheet 3, Real-time Clock]

Parts:
BT1: CR2032; BU2032
C12, C19: 0.1uF; C025-024X044
D2: 1N4148; DO35-7
J1: 1X2
J2: 1X2-THRU; 1X2
JP5: 1X2-THRU; 1X2
R3: 10k; 0207/10
R9: 100k; 0207/10
TP1: TP-040
U5: 74F138N; DIL16
U7: 74AHCT14N; DIL14
U12: DS1685; DIL24
U15: 7805Z; TO92
Y1: 32.768kHz; CRYSTAL-3X8N

Connections:
0V: BT1.N (-), C12.2, C19.2, J1.2, J2.2, JP5.2, U5.5 (G2B), U5.8 (0V), U7.7 (0V), U12.12 (0V), U12.16 (0V), U12.20 (VBAT), U15.2 (0V); also elsewhere on the board
!CS_RTC: U5.4 (G2A), U12.13 (!CS); also elsewhere on the board
!INT_RTC: R3.2, U12.19 (!IRQ); also elsewhere on the board
!RD: U5.3 (C); also elsewhere on the board
!WR: U5.2 (B); also elsewhere on the board
+5V: R3.1, U5.6 (G1), U5.16 (+5V), U7.14 (+5V); also elsewhere on the board
+12V: D2.A; also elsewhere on the board
A0: U5.1 (A); also elsewhere on the board
D0: U12.4 (AD0); also elsewhere on the board
D1: U12.5 (AD1); also elsewhere on the board
D2: U12.6 (AD2); also elsewhere on the board
D3: U12.7 (AD3); also elsewhere on the board
D4: U12.8 (AD4); also elsewhere on the board
D5: U12.9 (AD5); also elsewhere on the board
D6: U12.10 (AD6); also elsewhere on the board
D7: U12.11 (AD7); also elsewhere on the board
unnamed: JP5.1, U12.21 (!RCLR)
unnamed: TP1.1, U12.23 (SQW)
unnamed: U12.2 (X1), Y1.2
unnamed: U12.3 (X2), Y1.1
unnamed: U5.10 (Y5), U12.15 (!WR)
unnamed: U5.11 (Y4), U7.11 (I)
unnamed: U5.12 (Y3), U12.17 (!RD)
unnamed: C12.1, U12.24 (+5V), U15.1 (VO)
unnamed: U7.10 (O), U12.14 (ALE)
unnamed: J1.1, U12.1 (!PWR)
unnamed: J2.1, R9.1, U12.18 (!KS)
unnamed: C19.1, D2.C, U15.3 (VI)
unnamed: BT1.P1 (+), BT1.P2 (+), R9.2, U12.22 (VBAUX)

Notes on the sheet:
A0=0 W Address A0=1 R/W Data
NVRAM CLEAR
KICKSTART
POWER-ON OUTPUT
NVRAM is easily corrupted by low-amplitude negative transients. U15 and D2 prevent this.

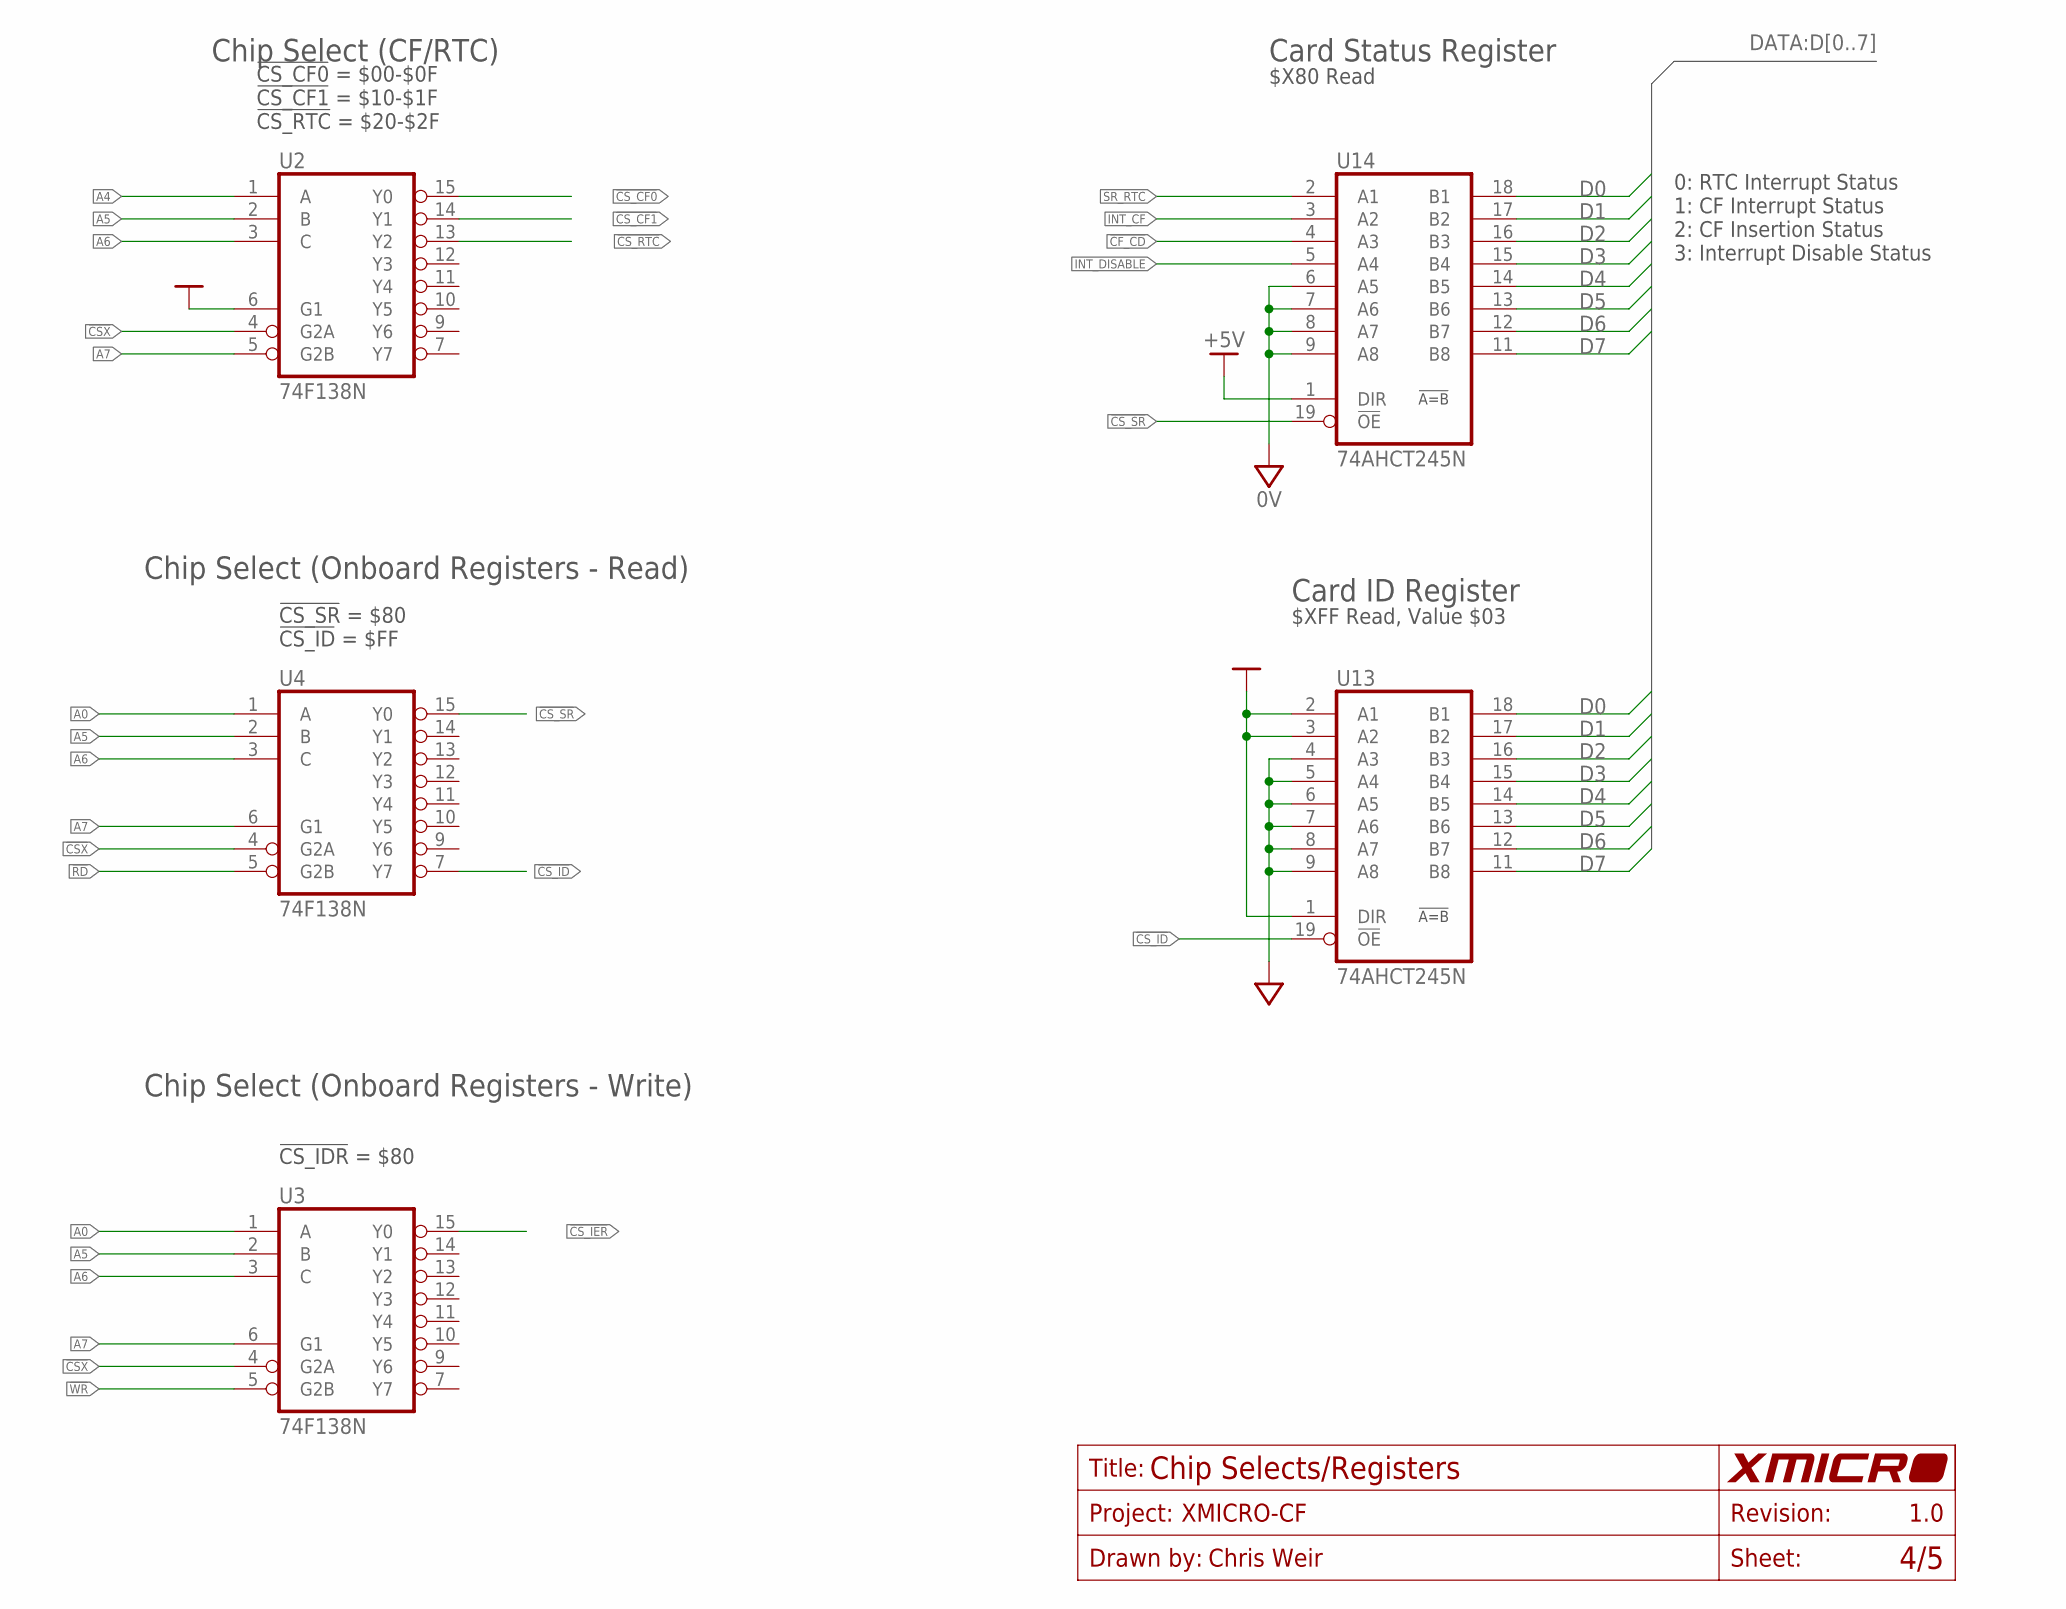
[picture p28: schematic XMICRO-CF V1.0.sch, sheet 4, Chip Selects/Onboard Registers]

Parts:
U2, U3, U4: 74F138N; DIL16
U13, U14: 74AHCT245N; DIL20

Connections:
0V: U2.8 (0V), U3.8 (0V), U4.8 (0V), U13.4 (A3), U13.5 (A4), U13.6 (A5), U13.7 (A6), U13.8 (A7), U13.9 (A8), U13.10 (0V), U14.6 (A5), U14.7 (A6), U14.8 (A7), U14.9 (A8), U14.10 (0V); also elsewhere on the board
!CF_CD: U14.4 (A3); also elsewhere on the board
!CSX: U2.4 (G2A), U3.4 (G2A), U4.4 (G2A); also elsewhere on the board
!CS_CF0: U2.15 (Y0); also elsewhere on the board
!CS_CF1: U2.14 (Y1); also elsewhere on the board
!CS_ID: U4.7 (Y7), U13.19 (!OE)
!CS_IER: U3.15 (Y0); also elsewhere on the board
!CS_RTC: U2.13 (Y2); also elsewhere on the board
!CS_SR: U4.15 (Y0), U14.19 (!OE)
!RD: U4.5 (G2B); also elsewhere on the board
!WR: U3.5 (G2B); also elsewhere on the board
+5V: U2.6 (G1), U2.16 (+5V), U3.16 (+5V), U4.16 (+5V), U13.1 (DIR), U13.2 (A1), U13.3 (A2), U13.20 (+5V), U14.1 (DIR), U14.20 (+5V); also elsewhere on the board
A0: U3.1 (A), U4.1 (A); also elsewhere on the board
A4: U2.1 (A); also elsewhere on the board
A5: U2.2 (B), U3.2 (B), U4.2 (B); also elsewhere on the board
A6: U2.3 (C), U3.3 (C), U4.3 (C); also elsewhere on the board
A7: U2.5 (G2B), U3.6 (G1), U4.6 (G1); also elsewhere on the board
D0: U13.18 (B1), U14.18 (B1); also elsewhere on the board
D1: U13.17 (B2), U14.17 (B2); also elsewhere on the board
D2: U13.16 (B3), U14.16 (B3); also elsewhere on the board
D3: U13.15 (B4), U14.15 (B4); also elsewhere on the board
D4: U13.14 (B5), U14.14 (B5); also elsewhere on the board
D5: U13.13 (B6), U14.13 (B6); also elsewhere on the board
D6: U13.12 (B7), U14.12 (B7); also elsewhere on the board
D7: U13.11 (B8), U14.11 (B8); also elsewhere on the board
INT_CF: U14.3 (A2); also elsewhere on the board
INT_DISABLE: U14.5 (A4); also elsewhere on the board
SR_RTC: U14.2 (A1); also elsewhere on the board

Notes on the sheet:
!CS_CF0! = $00-$0F !CS_CF1! = $10-$1F !CS_RTC! = $20-$2F
!CS_SR! = $80 !CS_ID! = $FF
0: RTC Interrupt Status 1: CF Interrupt Status 2: CF Insertion Status 3: Interrupt Disable Status
Chip Select (CF/RTC)
Chip Select (Onboard Registers - Read)
Card Status Register
Card ID Register
$X80 Read
$XFF Read, Value $03
!CS_IDR! = $80
Chip Select (Onboard Registers - Write)

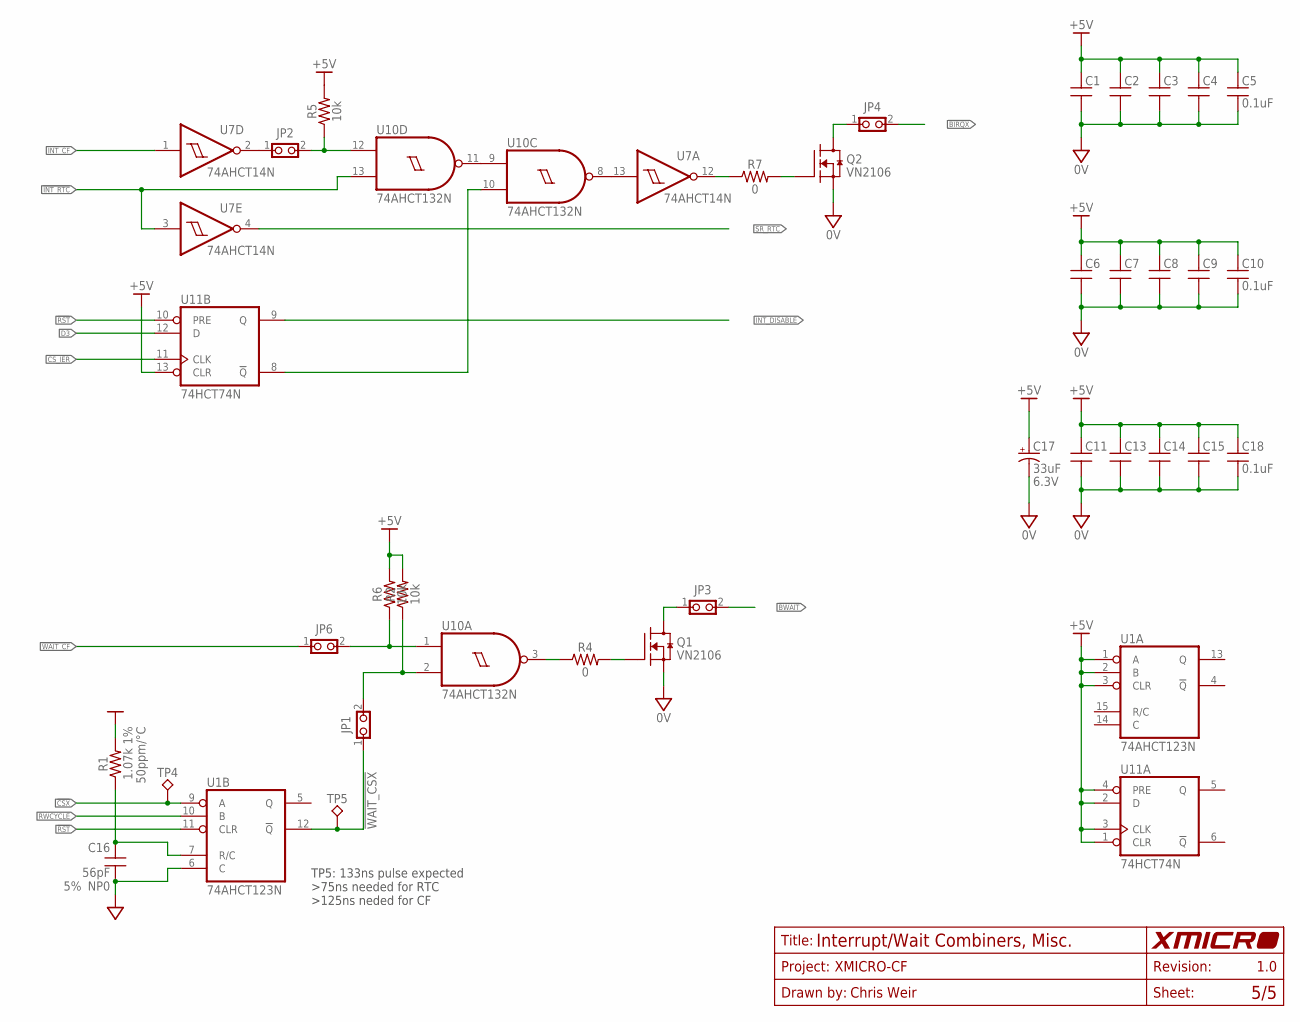
[picture p29: schematic XMICRO-CF V1.0.sch, sheet 5, Interrupt Combiner/Misc.]

Parts:
C1, C2, C3, C4, C5, C6, C7, C8, C9, C10, C11, C13, C14, C15, C18: 0.1uF; C025-024X044
C16: 56pF; C025-024X044; TOLERANCE 5%
C17: 33uF; E2,5-6; VOLTAGE 6.3V
JP1, JP2, JP3, JP4, JP6: 1X2-THRU; 1X2
Q1, Q2: VN2106; TO92
R1: 1.07k; 0207/10; TOLERANCE 1%
R2, R5, R6: 10k; 0207/10
R4: 0; 0207/10
R7: 0; 0207/12
TP4, TP5: TP-040
U1: 74AHCT123N; DIL16
U7: 74AHCT14N; DIL14
U10: 74AHCT132N; DIL14
U11: 74HCT74N; DIL14

Connections:
0V: C1.2, C2.2, C3.2, C4.2, C5.2, C6.2, C7.2, C8.2, C9.2, C10.2, C11.2, C13.2, C14.2, C15.2, C16.2, C17.-, C18.2, Q1.1 (S), Q2.1 (S), U1.6 (C), U1.8 (0V), U7.7 (0V), U10.7 (0V), U11.7 (0V); also elsewhere on the board
!BIRQX: JP4.2; also elsewhere on the board
!BWAIT: JP3.2; also elsewhere on the board
!CSX: TP4.1, U1.9 (A); also elsewhere on the board
!CS_IER: U11.11 (CLK); also elsewhere on the board
!INT_RTC: U7.3 (I), U10.13 (I1); also elsewhere on the board
!RST: U1.11 (CLR), U11.10 (PRE); also elsewhere on the board
!WAIT_CF: JP6.1; also elsewhere on the board
!WAIT_CSX: JP1.1, TP5.1, U1.12 (!Q)
+5V: C1.1, C2.1, C3.1, C4.1, C5.1, C6.1, C7.1, C8.1, C9.1, C10.1, C11.1, C13.1, C14.1, C15.1, C17.+, C18.1, R1.2, R2.2, R5.2, R6.2, U1.1 (A), U1.2 (B), U1.3 (CLR), U1.16 (+5V), U7.14 (+5V), U10.14 (+5V), U11.1 (CLR), U11.2 (D), U11.3 (CLK), U11.4 (PRE), U11.13 (CLR), U11.14 (+5V); also elsewhere on the board
D3: U11.12 (D); also elsewhere on the board
INT_CF: U7.1 (I); also elsewhere on the board
INT_DISABLE: U11.9 (Q); also elsewhere on the board
unnamed: U7.13 (I), U10.8 (O)
unnamed: JP2.1, U7.2 (O)
unnamed: Q1.2 (G), R4.2
unnamed: JP3.1, Q1.3 (D)
unnamed: JP6.2, R6.1, U10.1 (I0)
unnamed: Q2.2 (G), R7.2
unnamed: JP4.1, Q2.3 (D)
unnamed: U10.10 (I1), U11.8 (!Q)
unnamed: C16.1, R1.1, U1.7 (R/C)
unnamed: JP1.2, R2.1, U10.2 (I1)
unnamed: U10.9 (I0), U10.11 (O)
unnamed: JP2.2, R5.1, U10.12 (I0)
unnamed: R4.1, U10.3 (O)
unnamed: R7.1, U7.12 (O)
RWCYCLE: U1.10 (B); also elsewhere on the board
SR_RTC: U7.4 (O); also elsewhere on the board

Notes on the sheet:
TP5: 133ns pulse expected >75ns needed for RTC >125ns neded for CF

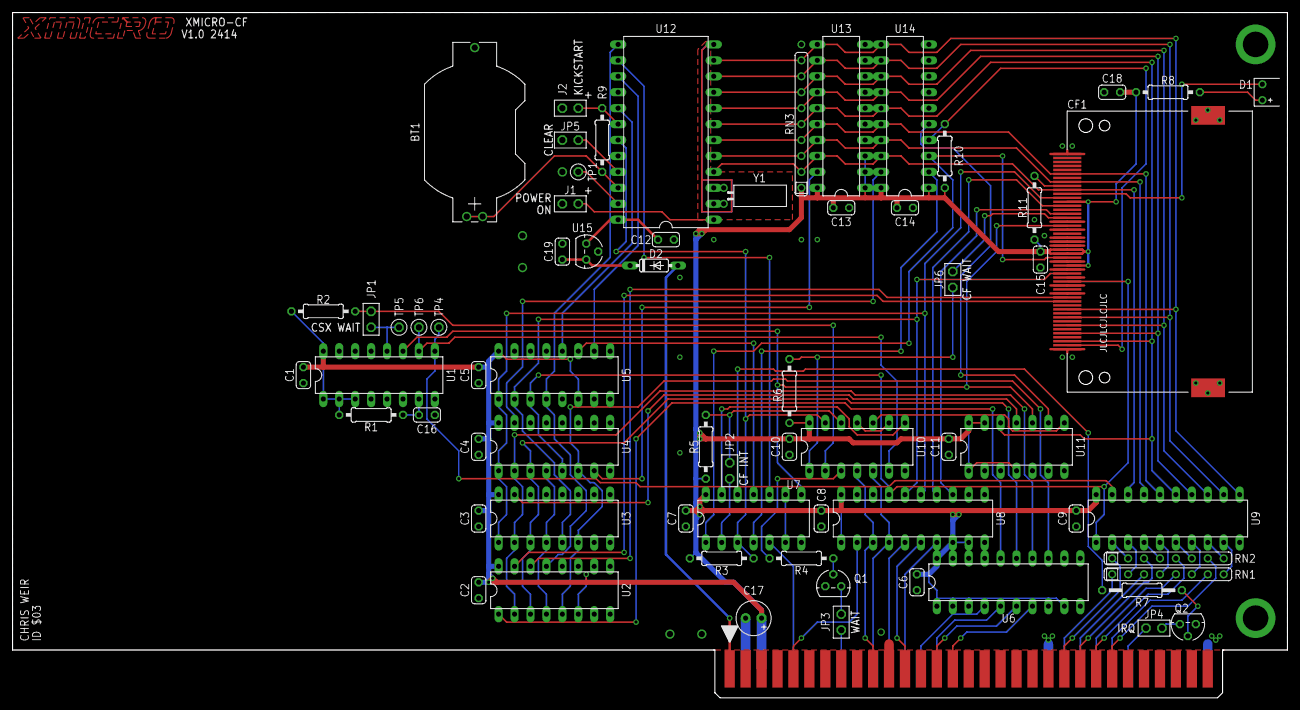
[picture p30: board XMICRO-CF V1.0.brd from above]

Board: 2 copper layers, 203.2 x 109.2 mm, 68 parts (0 on the bottom side), 96 nets.
